ProjectAliB/ProjectAli.github.io/README.md

[Robot Overview by ProjectAli.pdf](https://github.com/ProjectAliB/ProjectAli.github.io/files/14853153/Robot.Overview.by.ProjectAli.pdf)
