ProjectAliB/ProjectAli.github.io/Reports/Weekly reports/# Work session 13 -19032024.md

# Work session 12 - 19/03/2024

## Tasks overview

- Modeling the robot on Fusion 360, along with the robot components.
- Making the wooden base using Laser-cutting machine.

## Modeling

- Using Fusion 360, 4 pieces were modeled according to their dimensions and their position:
  - The wooden base.
  - The Arduino Uno micro-controller.
  - The Jetson nano mini-computer.
  - Bread board.

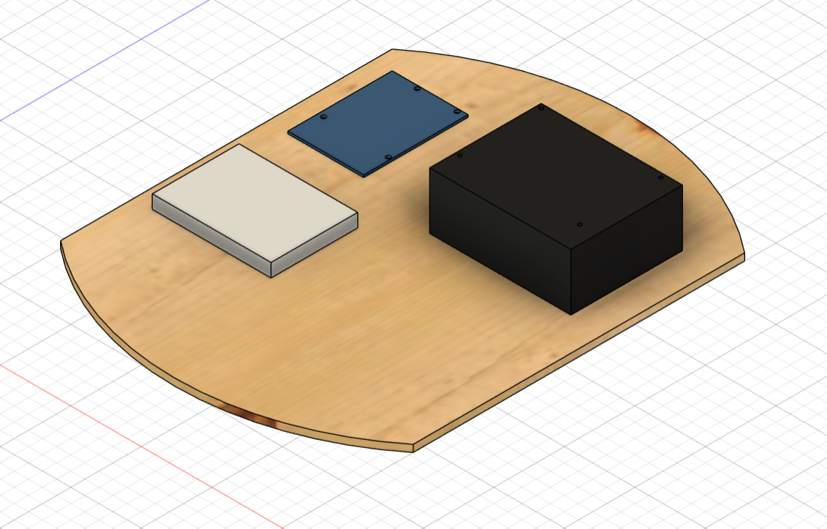
[picture p13: Ressources/Images&Pictures/Work session 13/Screenshot 2024-03-19 152109.png]

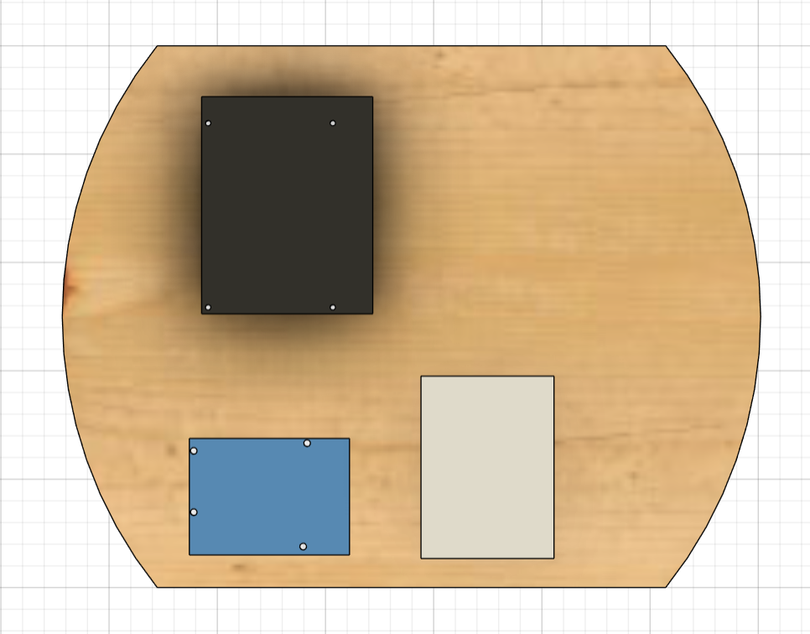
[picture p14: Ressources/Images&Pictures/Work session 13/Screenshot 2024-03-19 152143.png]


## Laser cutting

- Using the sketch from the 3D modeled wooden base as a base, making the wooden base with accurate measures was a success.

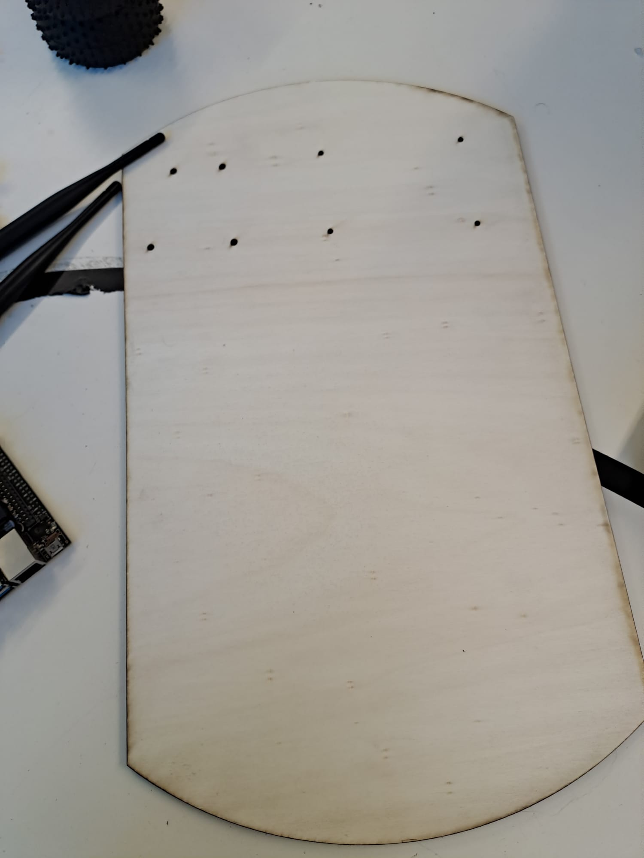
[picture p15: Ressources/Images&Pictures/Work session 13/WhatsApp Image 2024-03-19 at 15.00.32_1b3191f3.jpg]
Base


## Next steps

- Look for solutions for space and wires management.
- Mount other sensors on the robot.
