ProjectAliB/ProjectAli.github.io/Reports/Weekly reports/# Work session 09 - 13022024.md

# Work session 09 - 13/02/2004

## Overview

The focus of this work session was on the possible solutions available for making the front wheels, as well as the power supply for the robot.

## Front wheels

Two choices were available for making the front wheels:
- Have two big wheels, similar in size to the driving wheels, with 3 degrees of freedom using a ball bearing system. This solution put design and outward appearance over practicality as it is very complex to achieve using the available tools.

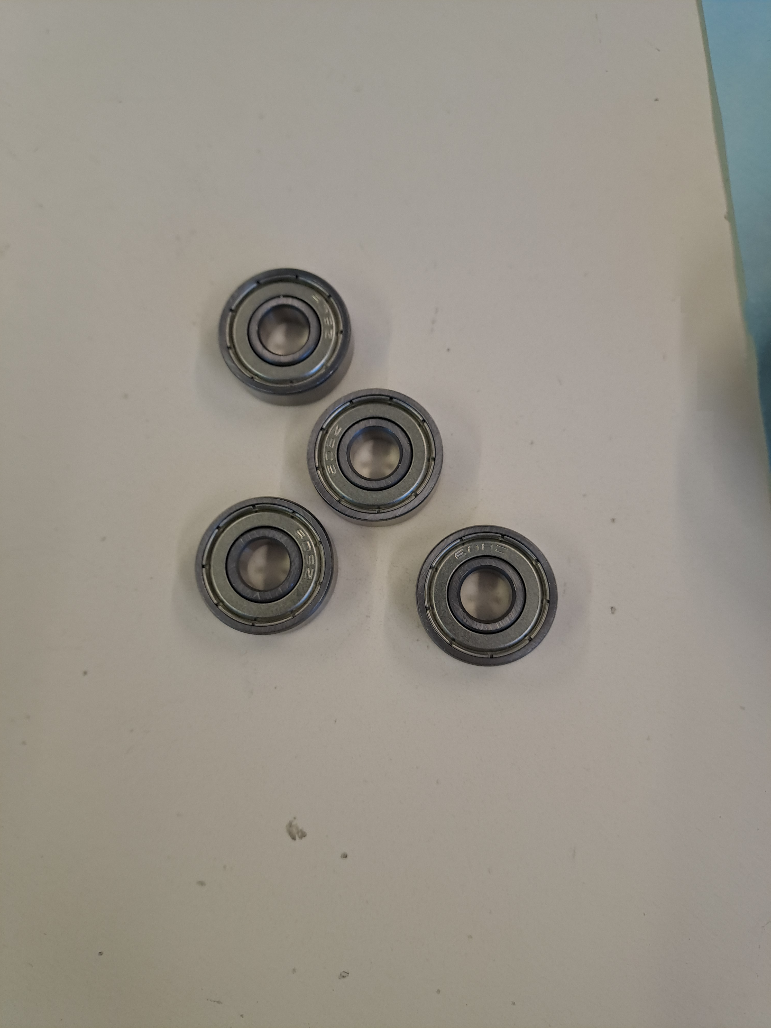
[picture p25: Ressources/Images&Pictures/Work session 10/20240213_103211.jpg]
ball-bearing system


- Using multi-directionnal wheels, a choice that would prioritize practicality over design, and the standard solution for similar robots.

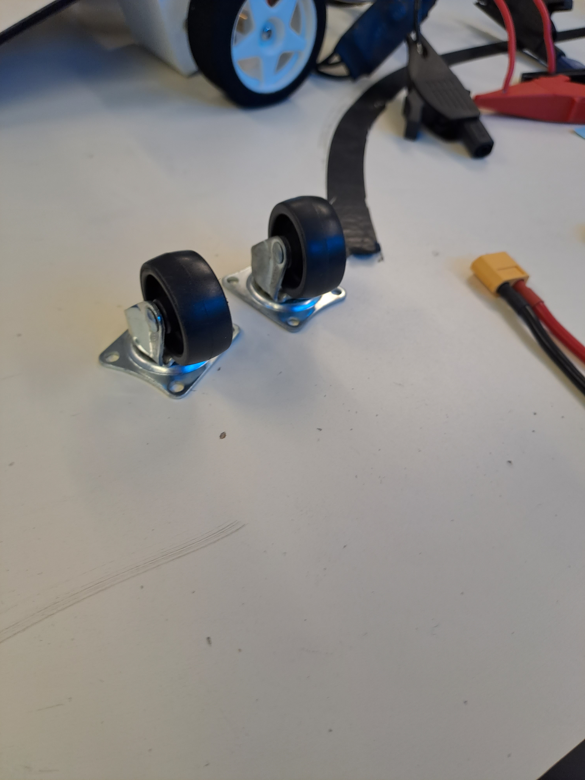
[picture p26: Ressources/Images&Pictures/Work session 10/20240213_103206.jpg]
Multi-directionnal wheels


The choice would be done later after testing both solutions.

## Power supply

In order to accuratly determine the power source (the battery), to use as a power supply for our robot, it is necessary to clarify what components of the robot would need power supply, and what are their specs.
The current situation requires the powering of two brushless motors, each one with the specs below according to their manufacturer:

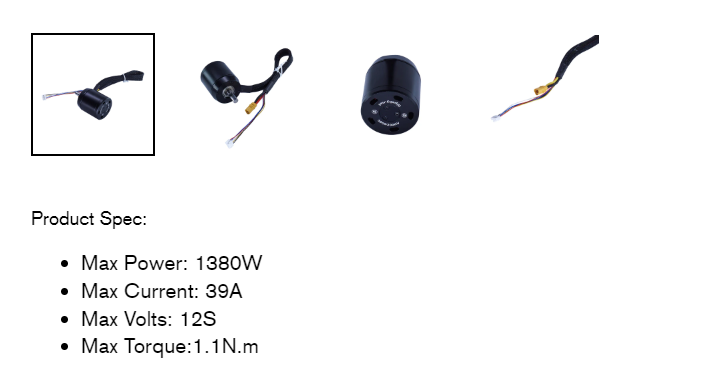
[picture p27: Ressources/Images&Pictures/Work session 10/Screenshot 2024-02-13 090609.png]
Motor specs


The capacity of the battery isn't a priority in the curent situation as this is a prototype.
As a result, the battery used should have the following specs:
- Rated current of 80A.
- Rated voltage of 12V.

Out of the available batteries, the one which is the most adapted is a rechargeable Lithium-Ion battery with thoe following specs:
- Rated current of 66A.
- Rated voltage of 11.1V.
- Capacity of 24.42Wh.

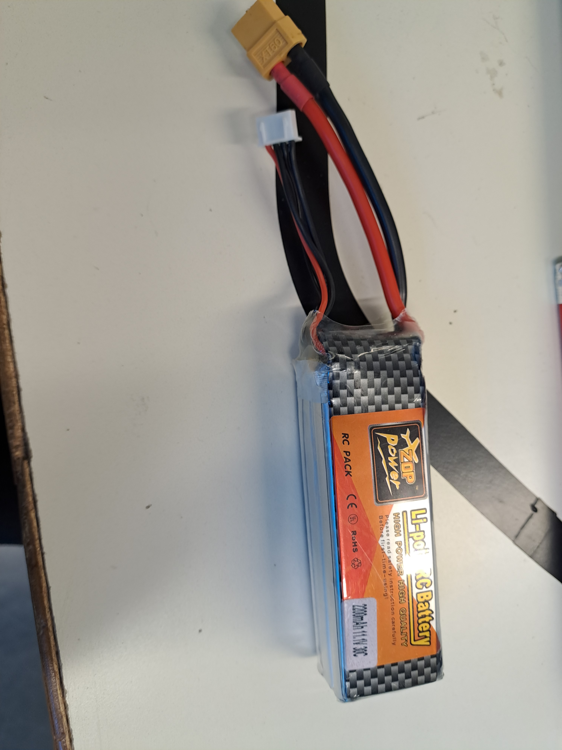
[picture p28: Ressources/Images&Pictures/Work session 10/20240213_091004.jpg]
Li-ion battery


In order to connect the motors to the battery, the following piece was used:

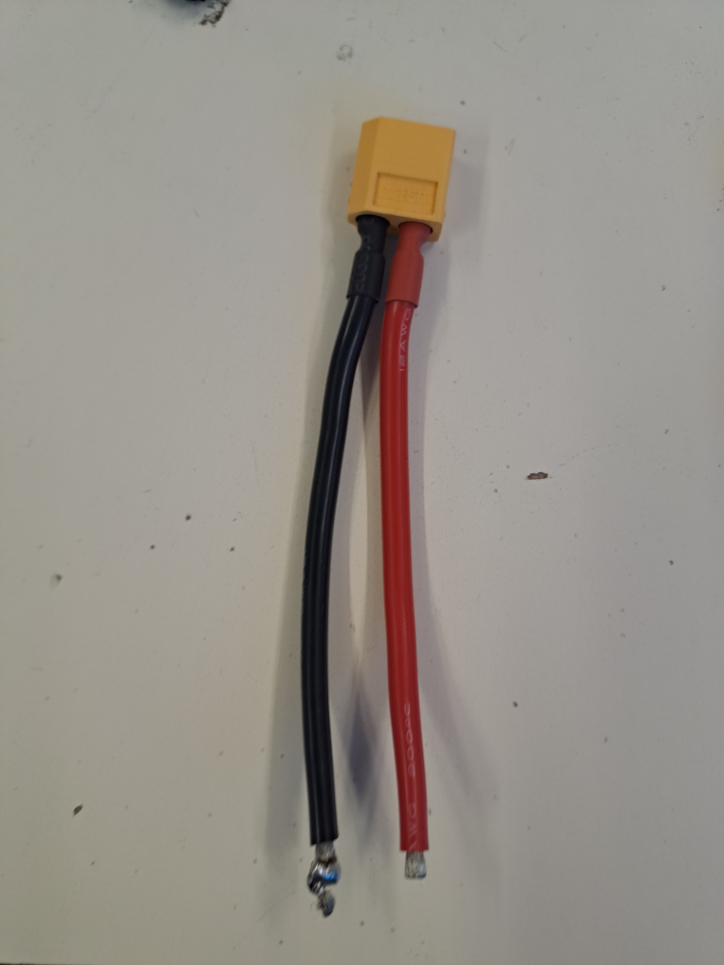
[picture p29: Ressources/Images&Pictures/Work session 10/20240213_103158.jpg]
Y piece


All that was left was welding the to motorrs wires together to connect them both to the battery.

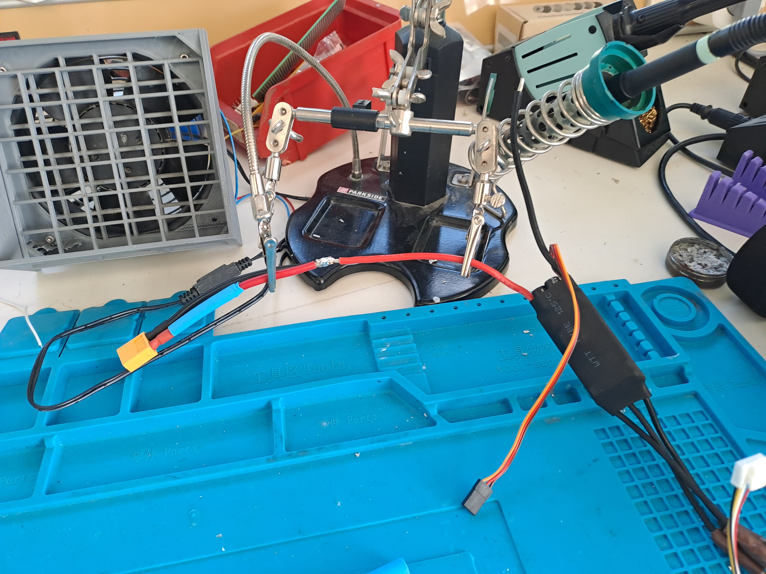
[picture p30: Ressources/Images&Pictures/Work session 10/20240213_105453.jpg]


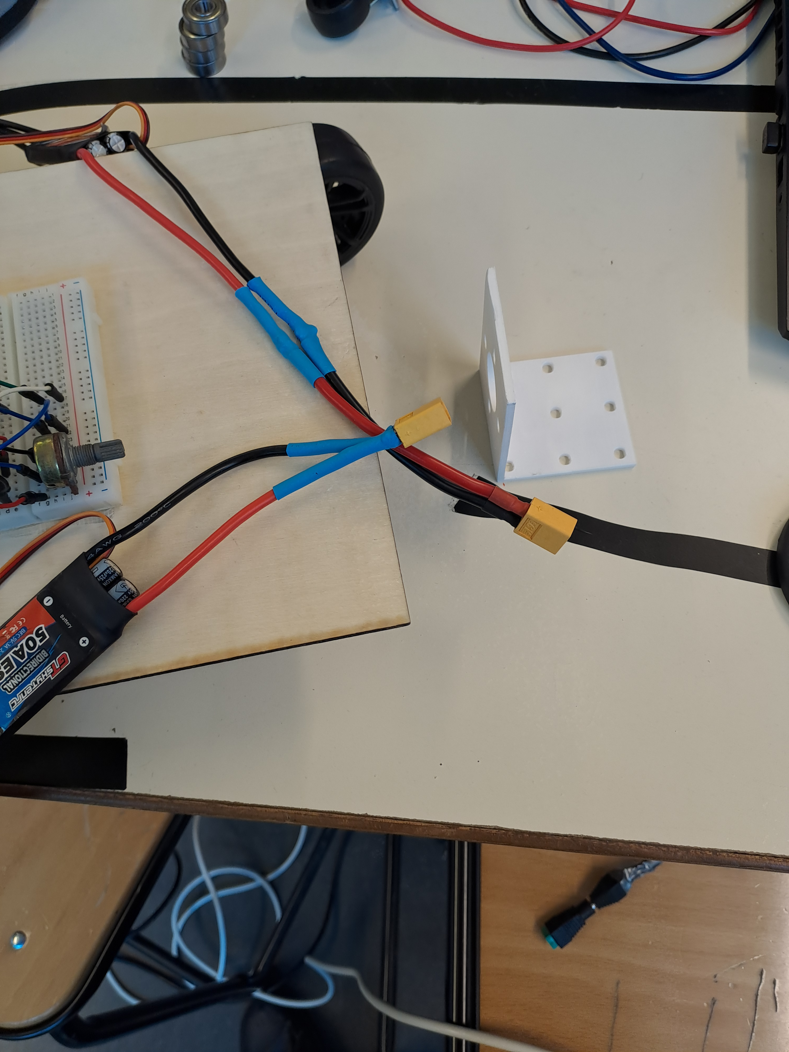
[picture p31: Ressources/Images&Pictures/Work session 10/20240213_113421.jpg]


## Next session goal

Finish welding the wires, connect it to the battery, and install the front wheels.
