ProjectAliB/ProjectAli.github.io/Reports/Weekly reports/# Work session 08 - 07022024.md

# Work session 08 - 07/02/2024

## Overview

During this session, my work consisted of fixing the motors to the frame, as well as fixing the wheels to the already fixed motors.

## Motor fixing

After printing the last version of the support, i fixed the motor to the said support using screw-nut.

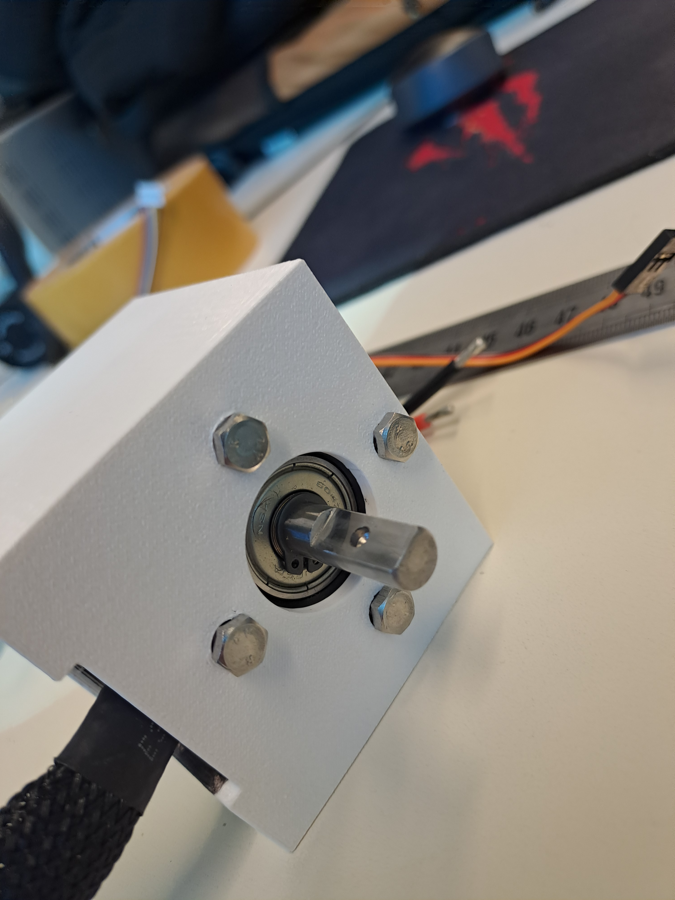
[picture p32: Ressources/Images&Pictures/Work session 08/20240207_151155.jpg]


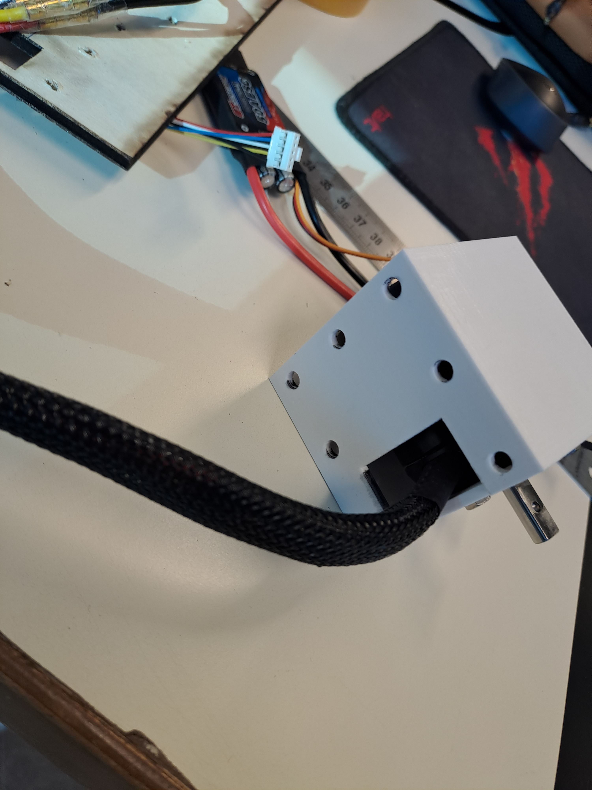
[picture p33: Ressources/Images&Pictures/Work session 08/20240207_151159.jpg]


Following that, I used it to try different positions on the frame. After finding the right position, I used a marker to mark the spot where the support is to be fixed.
I used a drill to bore a whole through the marked spots, making it possible to fix the support on the frame.

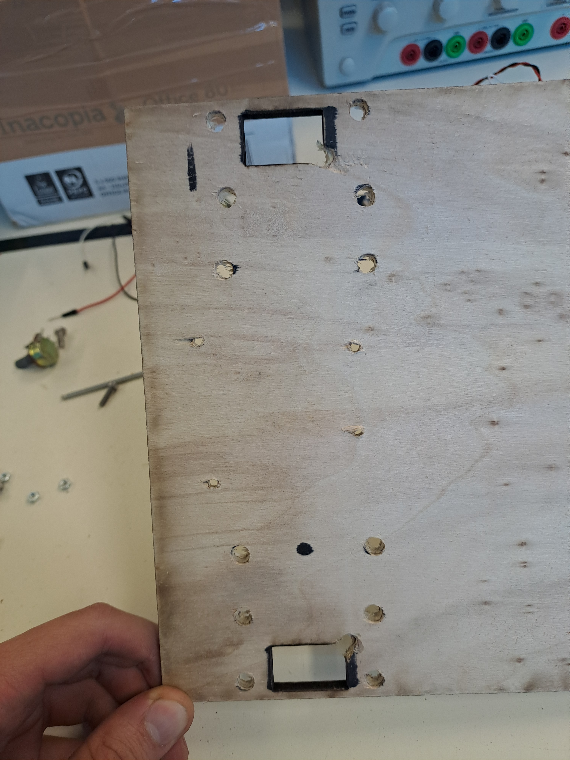
[picture p34: Ressources/Images&Pictures/Work session 08/20240207_153612.jpg]
Frame


## Wheel fixing

Now that the motor was fixed on the frame, it was time for wheels to be fixed to the motors.
I used a coupler connecter to connect the wheel to the motor.
Unfortunately, the connecter had smaller diameter compared to the motor's, which called for  perforation of the said piece to match our need.

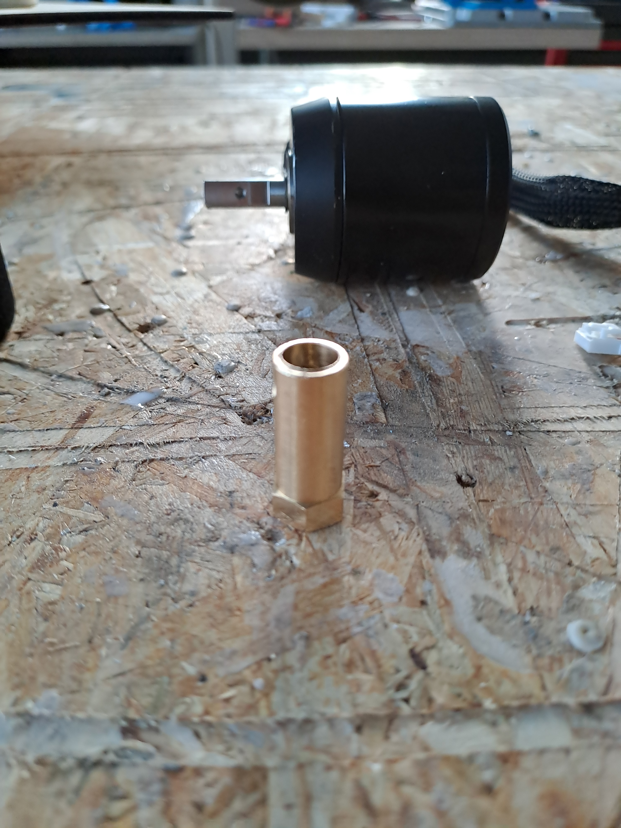
[picture p35: Ressources/Images&Pictures/Work session 08/20240207_172836.jpg]


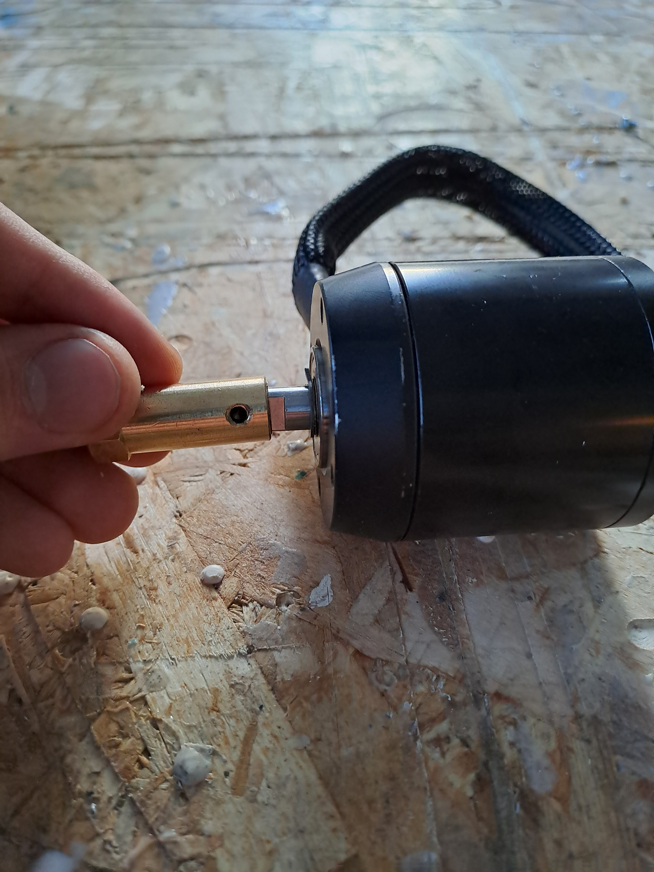
[picture p36: Ressources/Images&Pictures/Work session 08/20240207_172843.jpg]


All that was left was to fix the wheel to the other side of the connecter usig a screw.

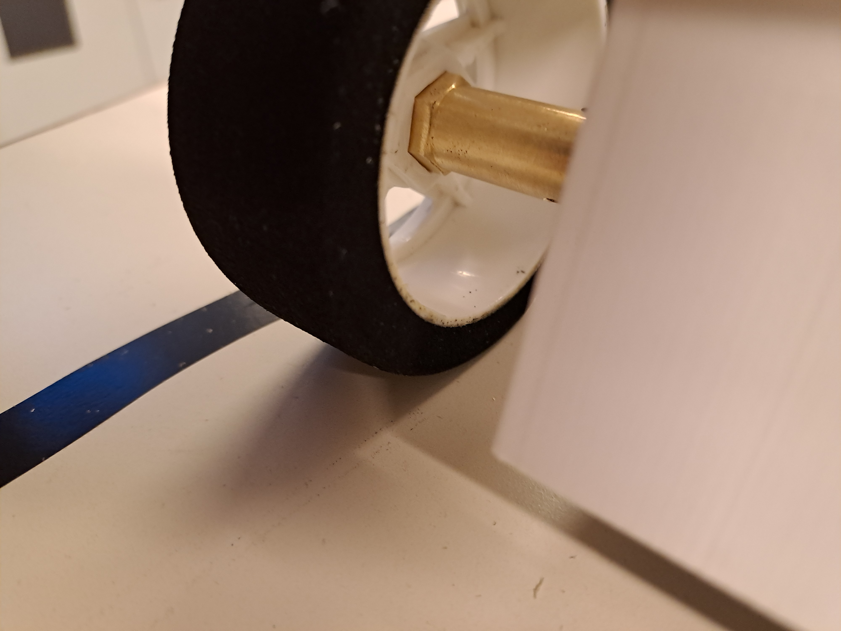
[picture p37: Ressources/Images&Pictures/Work session 08/20240207_174426.jpg]


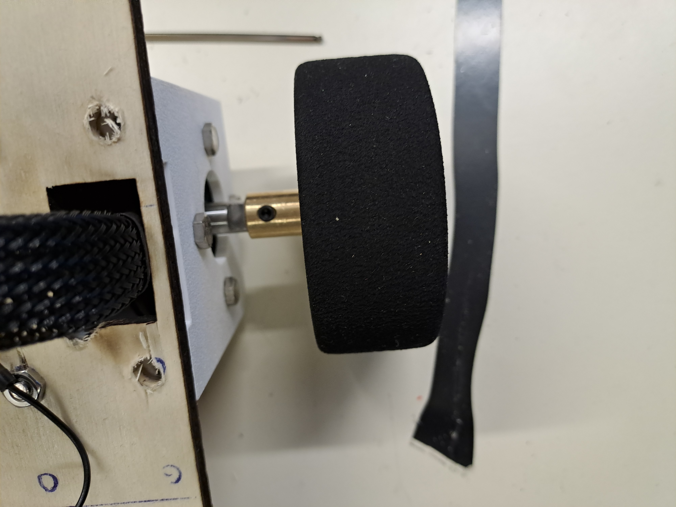
[picture p38: Ressources/Images&Pictures/Work session 08/20240207_174417.jpg]


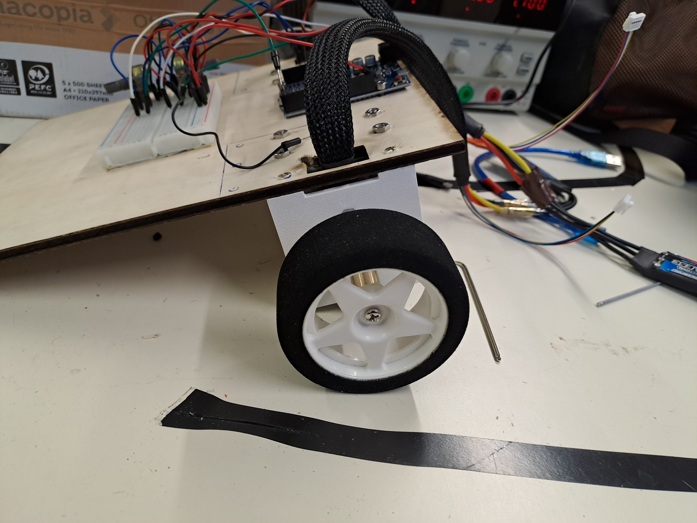
[picture p39: Ressources/Images&Pictures/Work session 08/20240207_174414.jpg]


## Next session goal

Make the robot's front wheel.
