ProjectAliB/ProjectAli.github.io/Reports/Weekly reports/# Work session 07 - 23012024.md

# Work session 07 - 23/01/2024

## Overview

My task this time consisted of reviewing the motor suport and fixing the electronic hardware in the robot frame.

## Motor support

After fixing the motor to the first version of the support using a screw-nut system, it appeared the support material wasn't rigid enough to support the weight of the motor.

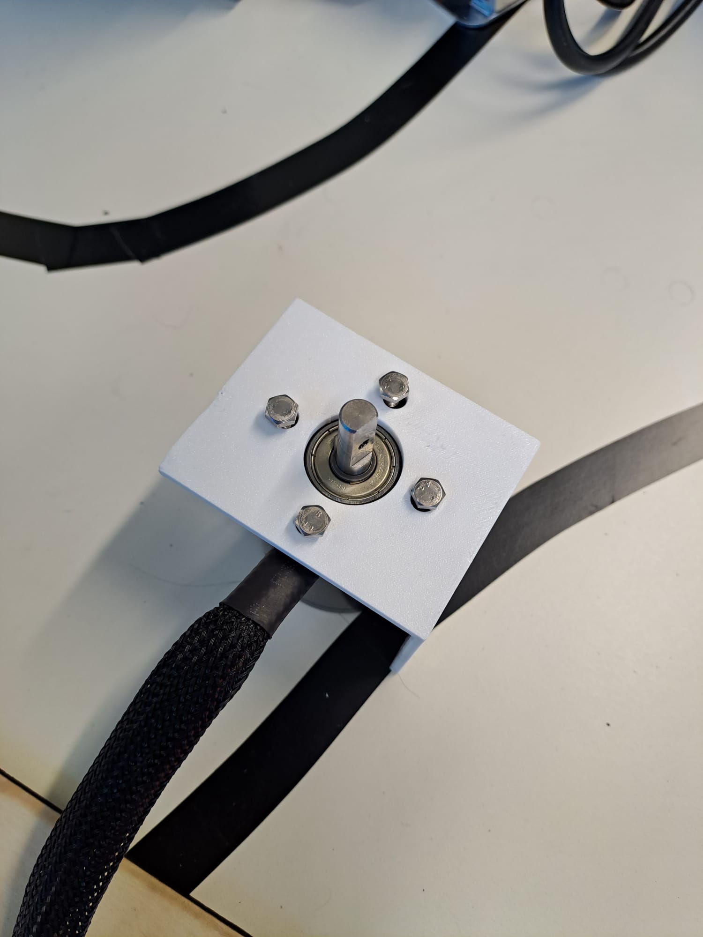
[picture p40: Ressources/Images&Pictures/Work session 07/IMG-20240123-WA0006.jpg]
Support Vers 1.0


As a result, i modeled a second one with butress from each side of the support to further support the motor and ensure the durability of the material.
Moreover, as the wires of the motor were getting in the way of the support, i took that into consideration and made a rectangular slot at the base of the support to avoid any perturbations dring the robot's movement.

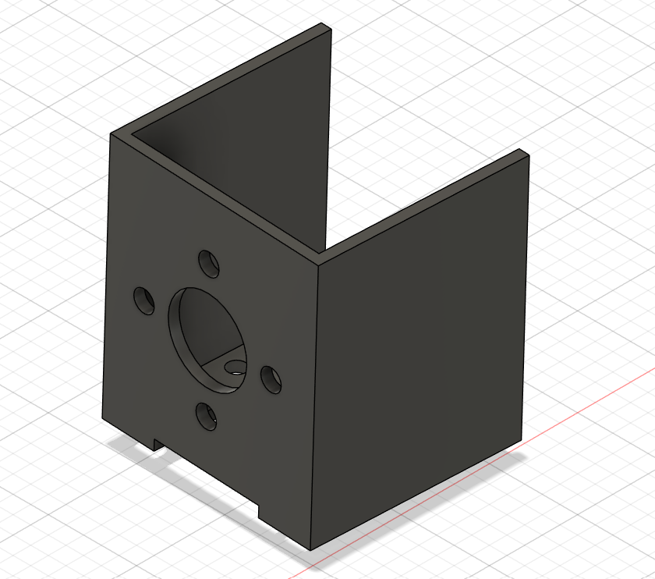
[picture p41: Ressources/Images&Pictures/Work session 07/Screenshot 2024-01-23 093651.png]


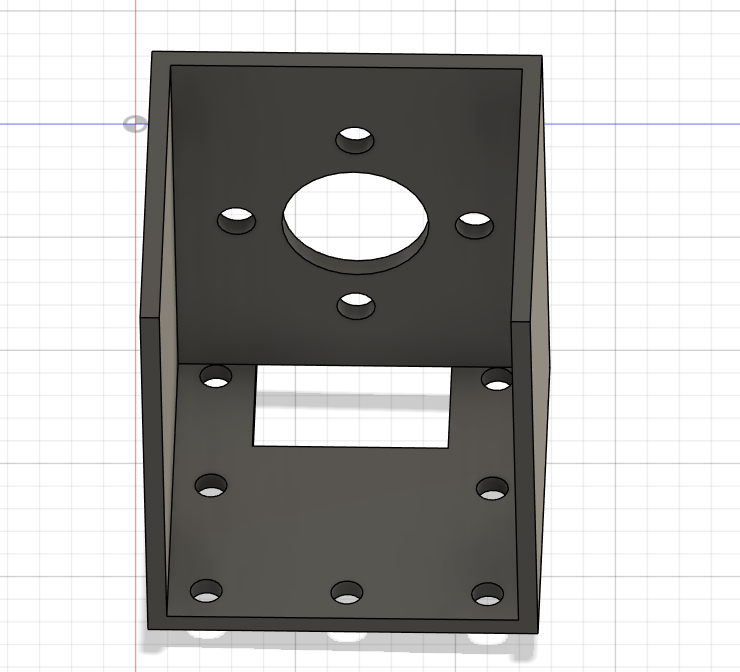
[picture p42: Ressources/Images&Pictures/Work session 07/Screenshot 2024-01-23 093956.png]


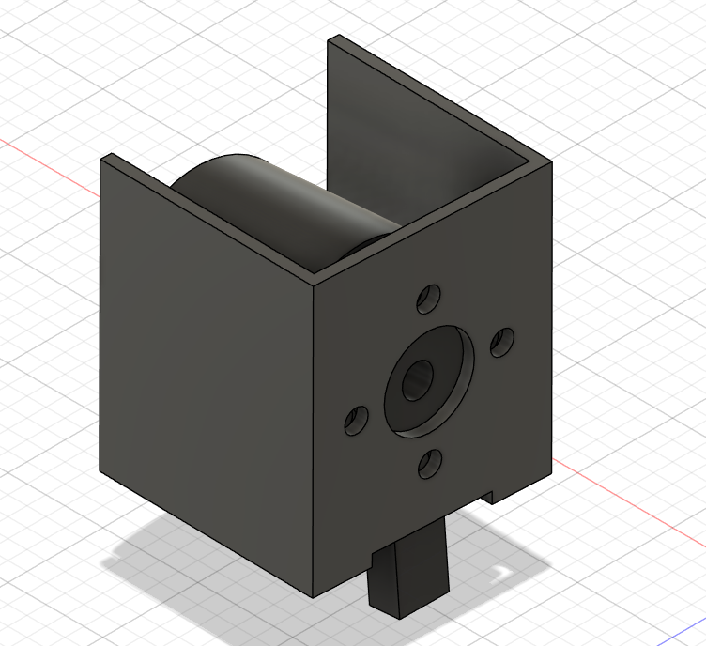
[picture p43: Ressources/Images&Pictures/Work session 07/Screenshot 2024-01-23 094402.png]


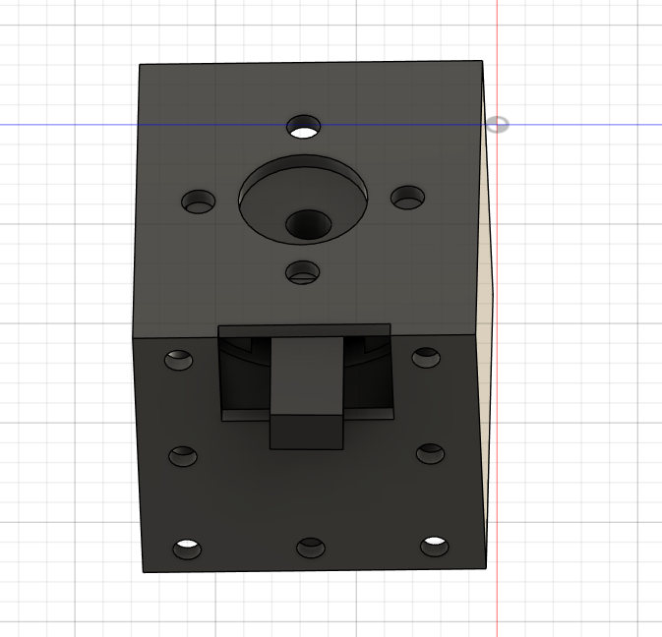
[picture p44: Ressources/Images&Pictures/Work session 07/Screenshot 2024-01-23 094431.png]


## Frame Fixing

Using the wood plan from last time as a frame for the robot, i fixed both the micro-controller (Arduino Uno) and the breadboard, using a screw-nut system for the first and a double sided tape for the second.

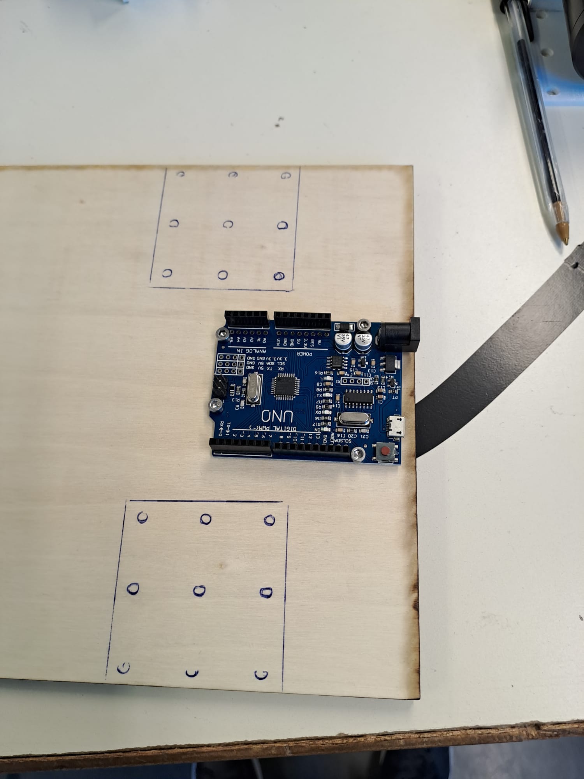
[picture p45: Ressources/Images&Pictures/Work session 07/IMG-20240123-WA0002.jpg]


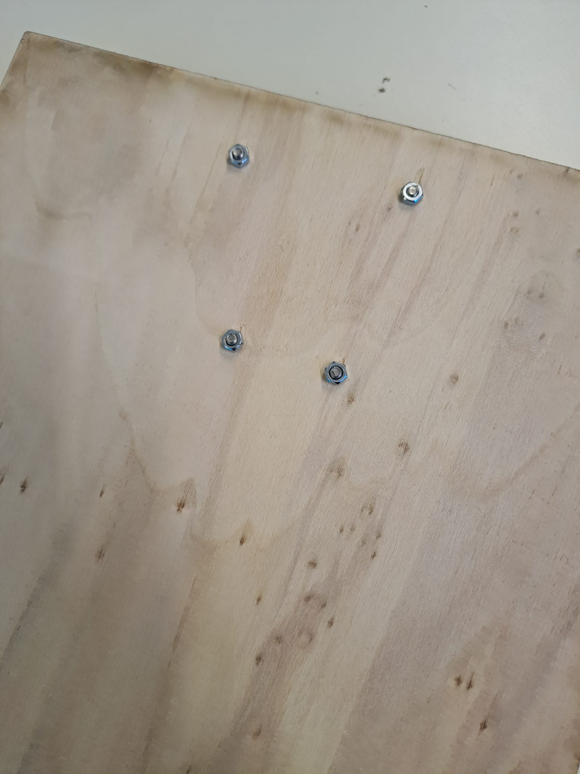
[picture p46: Ressources/Images&Pictures/Work session 07/IMG-20240123-WA0003.jpg]


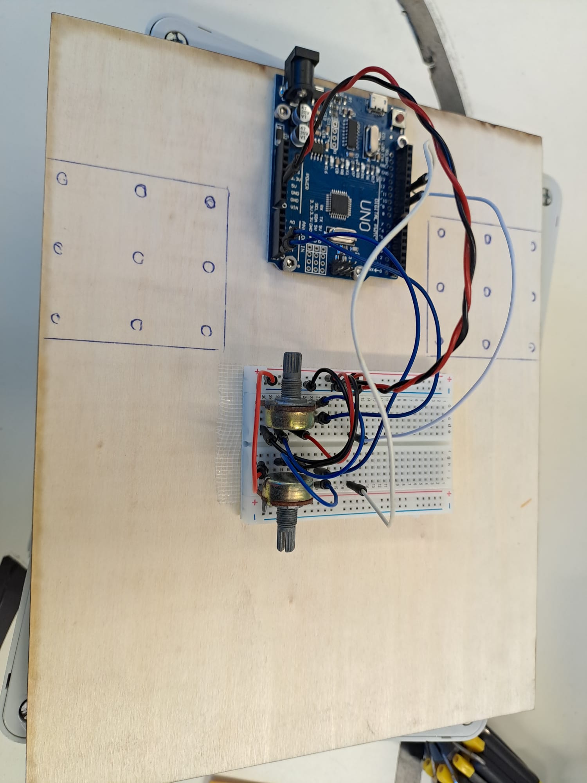
[picture p47: Ressources/Images&Pictures/Work session 07/IMG-20240123-WA0004.jpg]
Breadboard

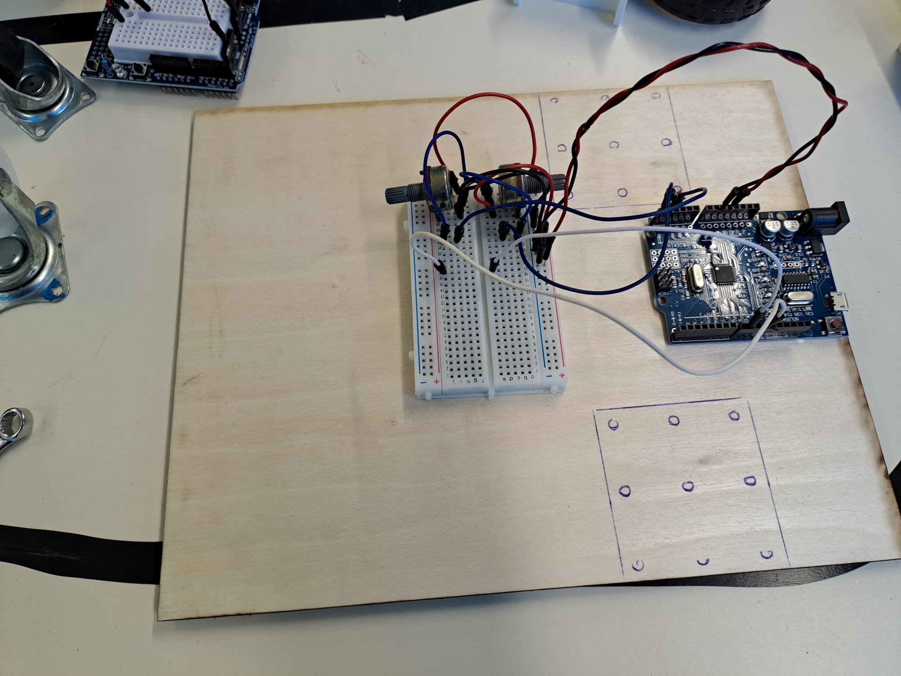
[picture p48: Ressources/Images&Pictures/Work session 07/IMG-20240123-WA0007.jpg]
Frame


## Next session goal

Reviewing the new version of the support and fix it along with the motors on the robot frame. Start working on the robot wheels.
