ProjectAliB/ProjectAli.github.io/Reports/Weekly reports/# Work session 06 - 16012024.md

# Work session 06 - 16/01/2024

## Overview

During this work session, i focused on setting the robot frame.

## Robot frame

I printed the motor support that i modeled before using a 3D printer. The results were satisfying as all the measures were right. I then moved on to place the support on what would the base of the robot. It is a rectangular wood plank 5mm in thickness and about 300mm in width and 500mm in lenth obtained using laser cutting.

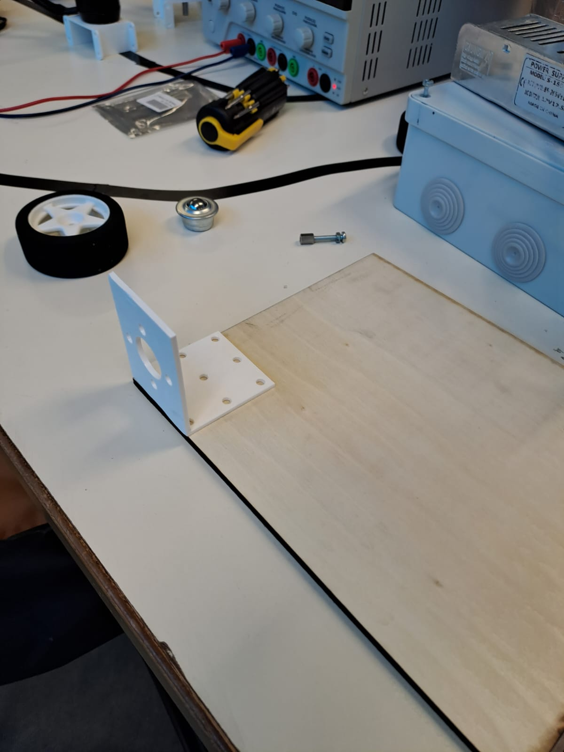
[picture p49: Ressources/Images&Pictures/Work session 06/WhatsApp Image 2024-01-17 at 10.24.28_634c170a.jpg]
Support+Plank


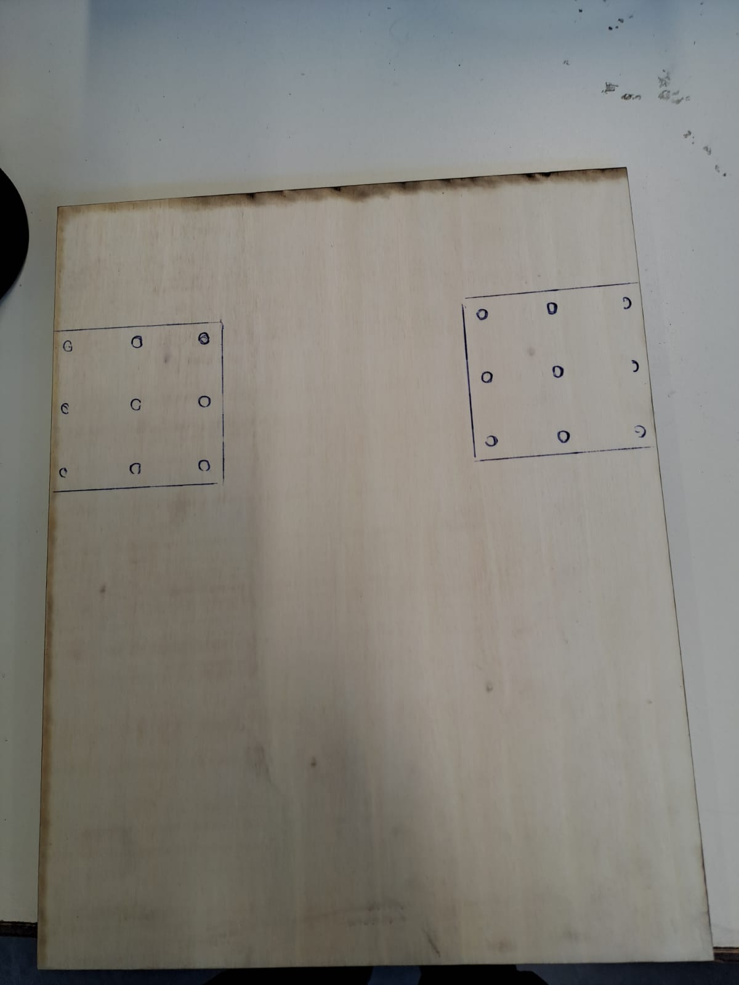
[picture p50: Ressources/Images&Pictures/Work session 06/WhatsApp Image 2024-01-17 at 10.24.28_70d6efe8.jpg]
Support Position


However, due to the motor's considerable weight, it may be better to add a butress at each side of the support to ensure that it will not break due to the motor's weight.

## Next session's goal

Make an enhanced version of the support using butress. Test the new printed piece and fix it on the wood plank.
