ProjectAliB/ProjectAli.github.io/Reports/Weekly reports/# Work session 01 - 13112023.md

# Work session 01 - 13/11/2023

## Overview

My work this session was mainly focused on finding the right motor that fulfills our need for the vehicle.

## Documentation

Our aim is to build a vehicle that respects the following criteria:
- Light-wheighted
- Speed reaching 45km/h
- Cheap and affordable
- Simple to assemble
- Long cycle of life
- Energy efficient

Having an motor adapted to those needs is therefore neccessary. Out of the many suppliers and manufactures of motors, we limited our options to the following ones:
- [Ozo ](https://ozo-electric.com/fr/moteurs-roues-arrieres-250w-a-2000w/991015-moteur-dd35-transport-arriere-direct-drive-2000w.html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)
- [AliExpress ](https://fr.aliexpress.com/item/1005004625728818.html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)
- [CDiscount ](https://www.cdiscount.com/le-sport/velos-tandem-tricycle-monocycle-remorque-casque/ashata-moteur-de-moyeu-de-roue-de-14-po-36v-72v-20/f-121192408-ash1690390599089.ht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)

AS the three motors share nearly the same specifics, after a careful consideration of the product's price, delivering fees, and the possibility to contact the manufacturer when needed, we chose the Ozo product:
Ozo hub motor
Motor's dimensions(mm)
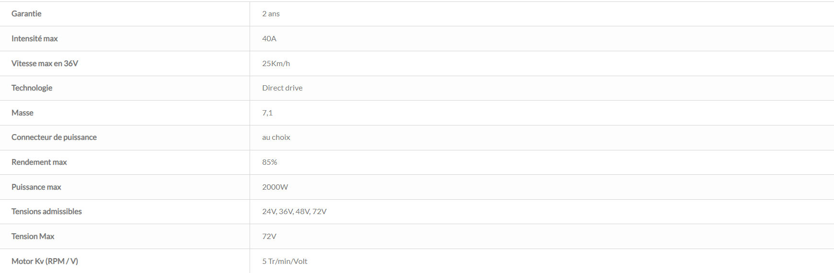
[picture p69: Ressources/Images&Pictures/Screenshot 2023.png.png]
Technical sheet


  ## Motor test

As it is my first time using a brushless motor, i tried using one and making it run at a certain speed. The used code was as follows :

    const int moteur=5;
    void setup(){
    pinMode(moteur,OUTPUT);
    Serial.begin(9600);
    }
    void loop(){
    digitalWrite(moteur,0);
    digitalRead(moteur);
    delay(5000);
    digitalWrite(moteur,1);
    digitalRead(moteur);
    }
Carefully connecting each wire into its suitable pin, there was no apparent mistake in the installation.

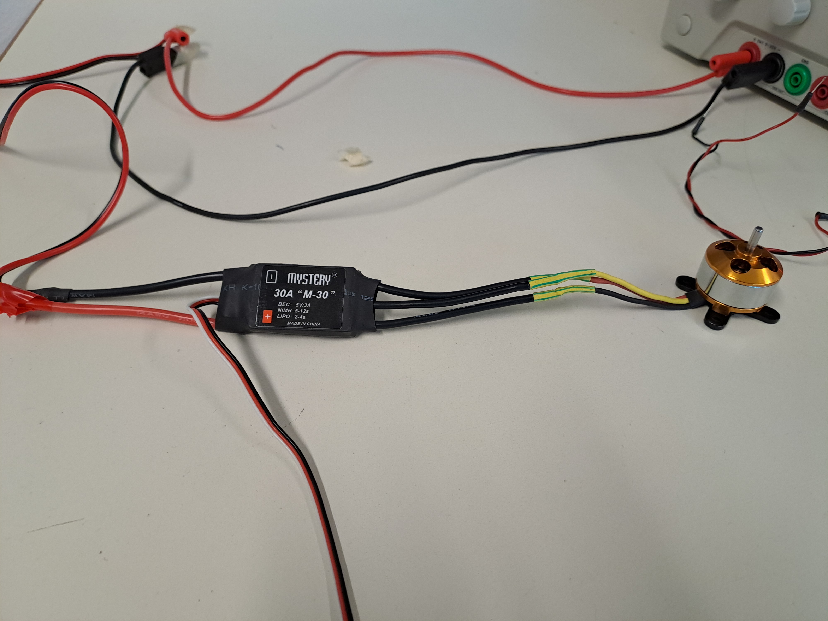
[picture p70: Ressources/Images&Pictures/20231116_153714.jpg]

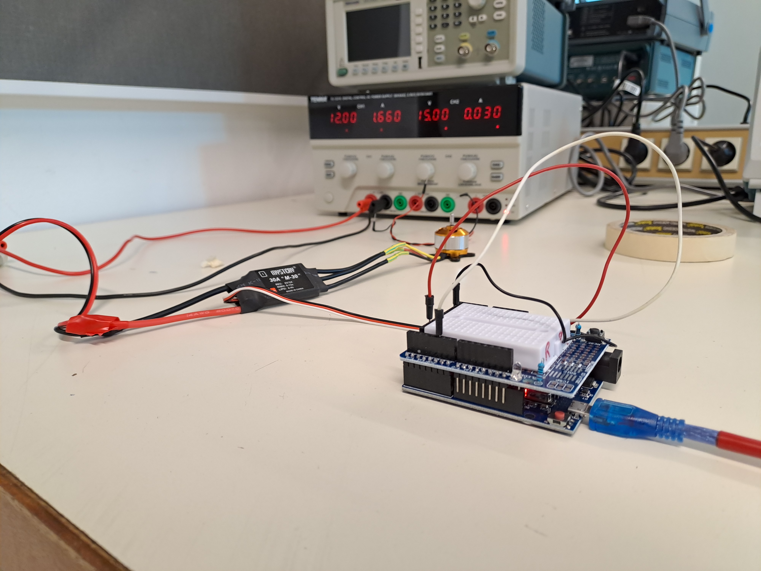
[picture p71: Ressources/Images&Pictures/20231116_153720.jpg]


The motor however still didn't seem to be working, although it was alimented by 12V. The problem may reside ine the code.

## Next goal

Looking for a code that enables me to control the speed of the brushless motor.
