ProjectAliB/ProjectAli.github.io/Soutenance Projet/Support_soutenance.pdf

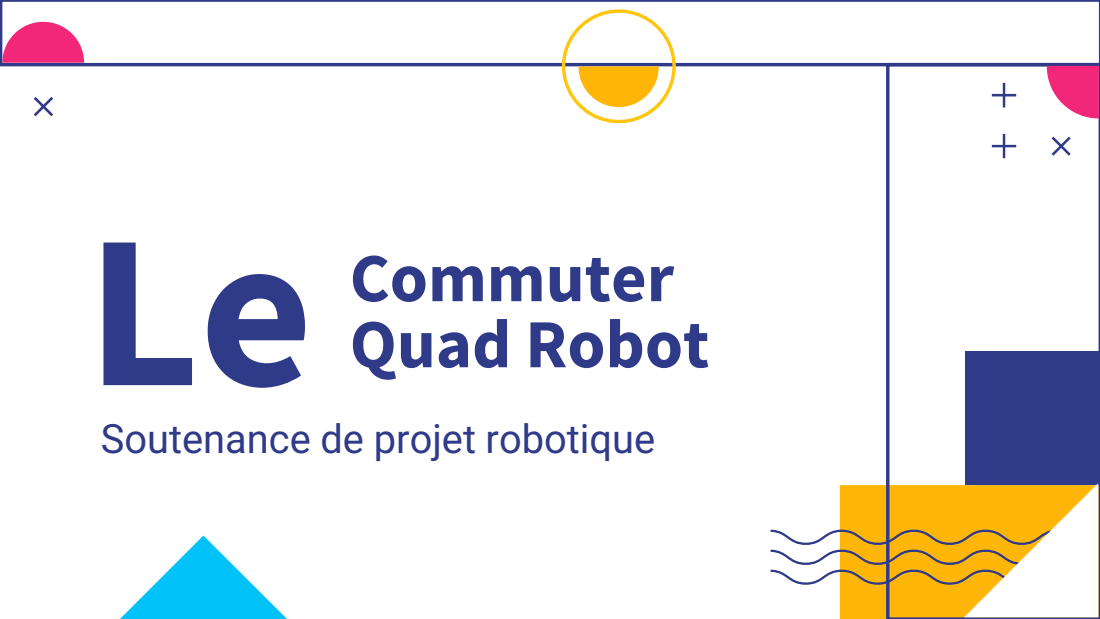
[picture p83: page 1]
Commuter Quad Robot

Soutenance de projet robotique

# Table des matières

01 Introduction | Explication du cadre du projet
02 Synopsis | Synopsis de l’architecture
03 Machine à état | Clarification du processus
04 Choix faits | Justification des options prises
05 Futures tâches | Les évolutions à venir

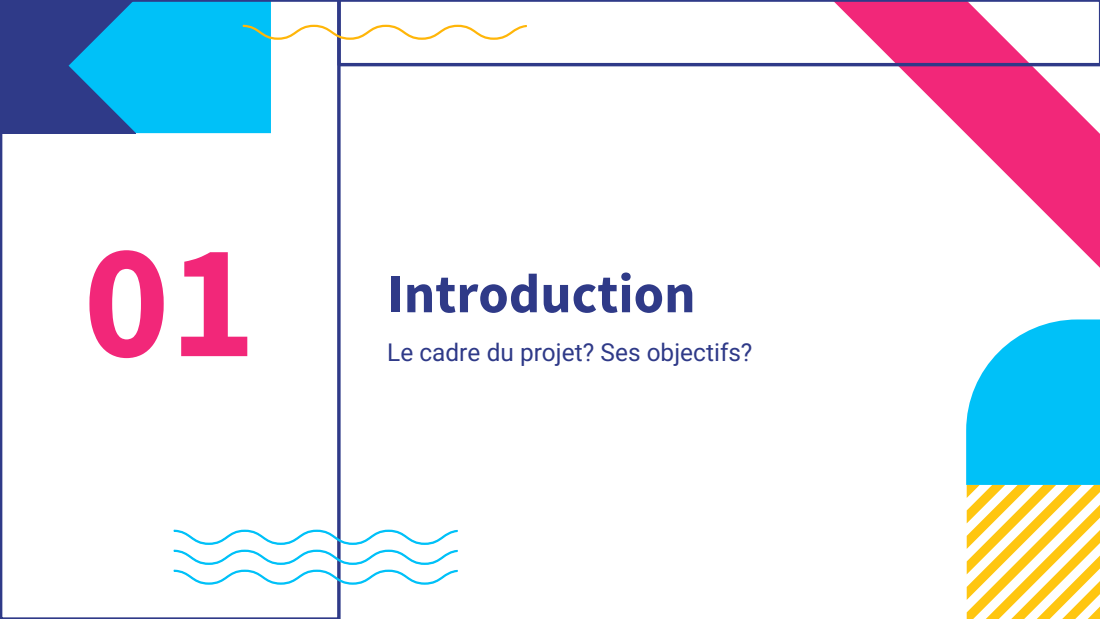
[picture p84: page 3]
Introduction 01; Le cadre du projet? Ses objectifs?

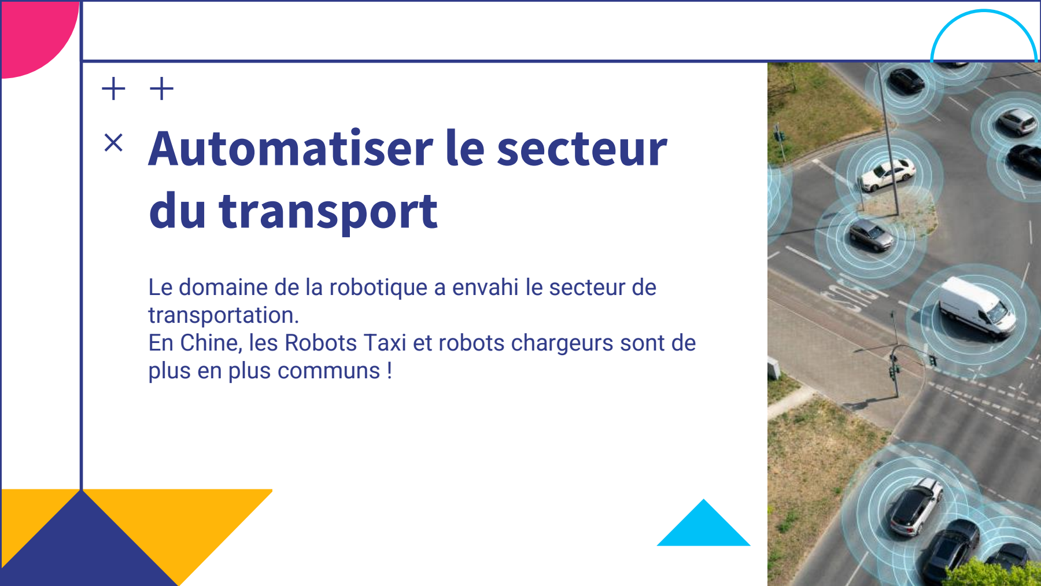
[picture p85: figure]
Automatiser le secteur du transport; transportation.; plus en plus communs !

Le domaine de la robotique a envahi le secteur de

En Chine, les Robots Taxi et robots chargeurs sont de

# Objectifs

Non-soumis au
nombre limité
d’heure de travail

24h24 7J/7

Peu-consommant et
auto-suffisant en
énergie

## Auto-suffisant

Capable d’une
variété de
manoeuvres en
fonction de la
situation

## Intelligent

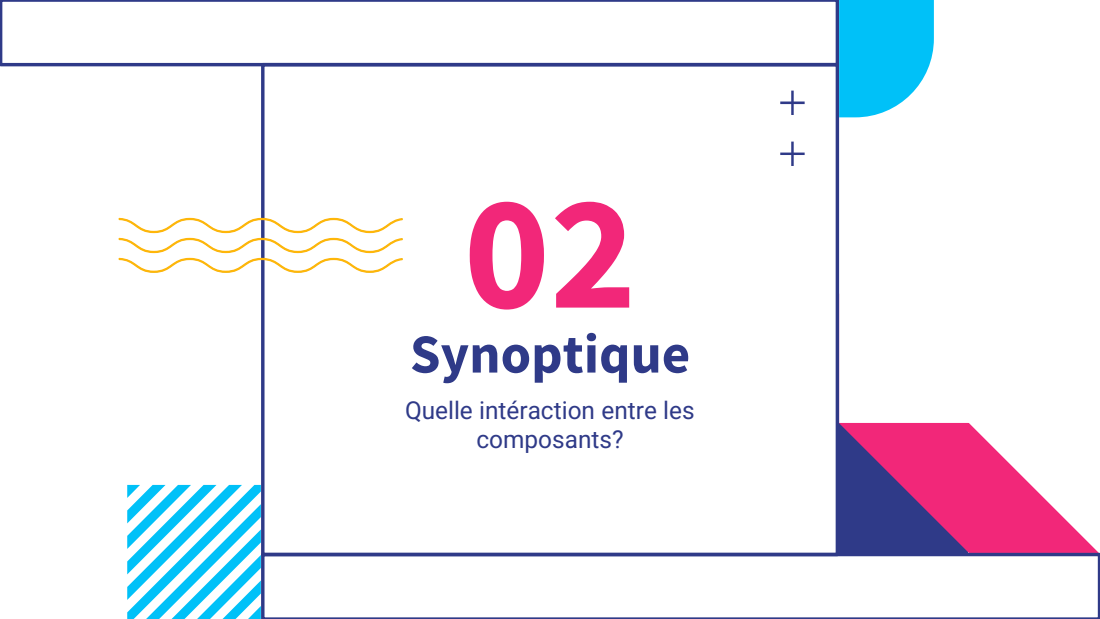
[picture p86: page 6]
Synoptique

Quelle intéraction entre les
composants?

# Composants du robot

## Ordinateur de bord

Caméra | Microcontrôleur
Moteurs | Driver | Servomoteur

# Synopsis simple

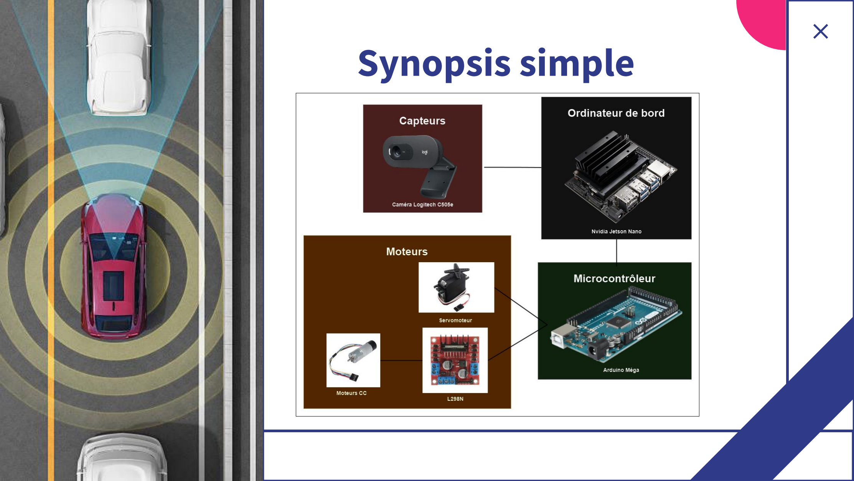
[picture p87: page 8]
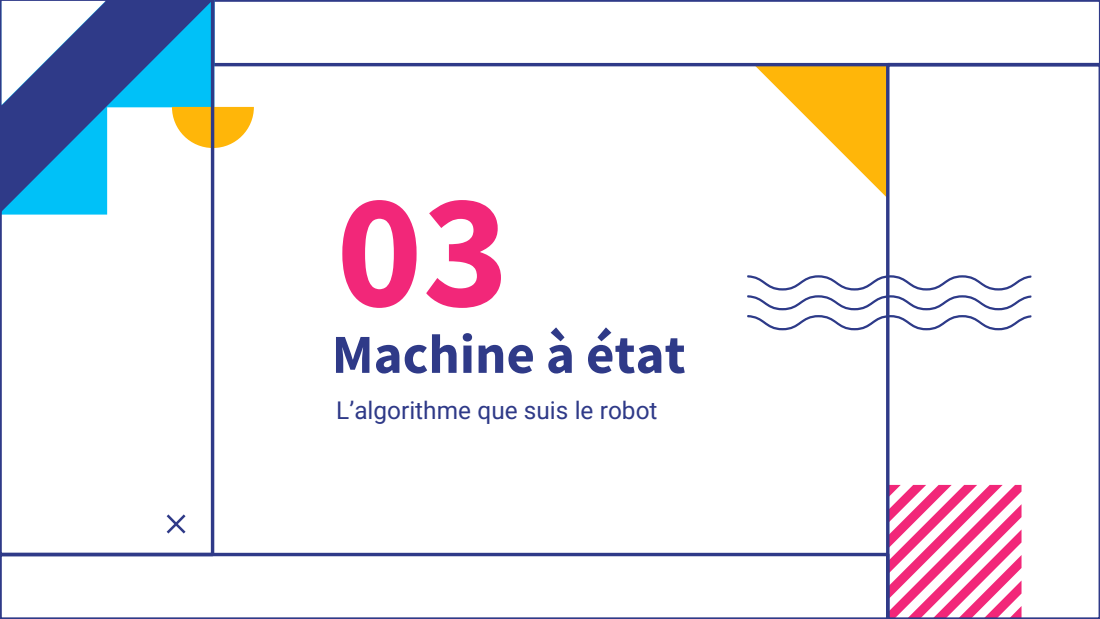
[picture p88: page 9]
Machine à état

L’algorithme que suis le robot

# Les 3 états du robot

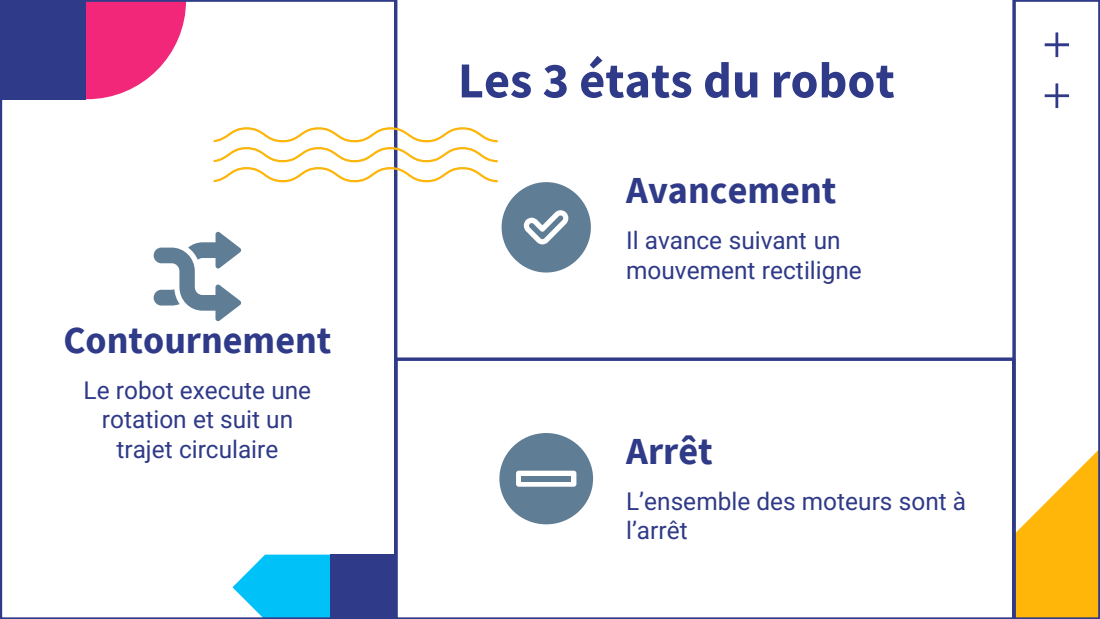
[picture p89: page 10]
Contournement; Avancement; Arrêt

Il avance suivant un
mouvement rectiligne

Le robot execute une
rotation et suit un
trajet circulaire

L’ensemble des moteurs sont à
l’arrêt

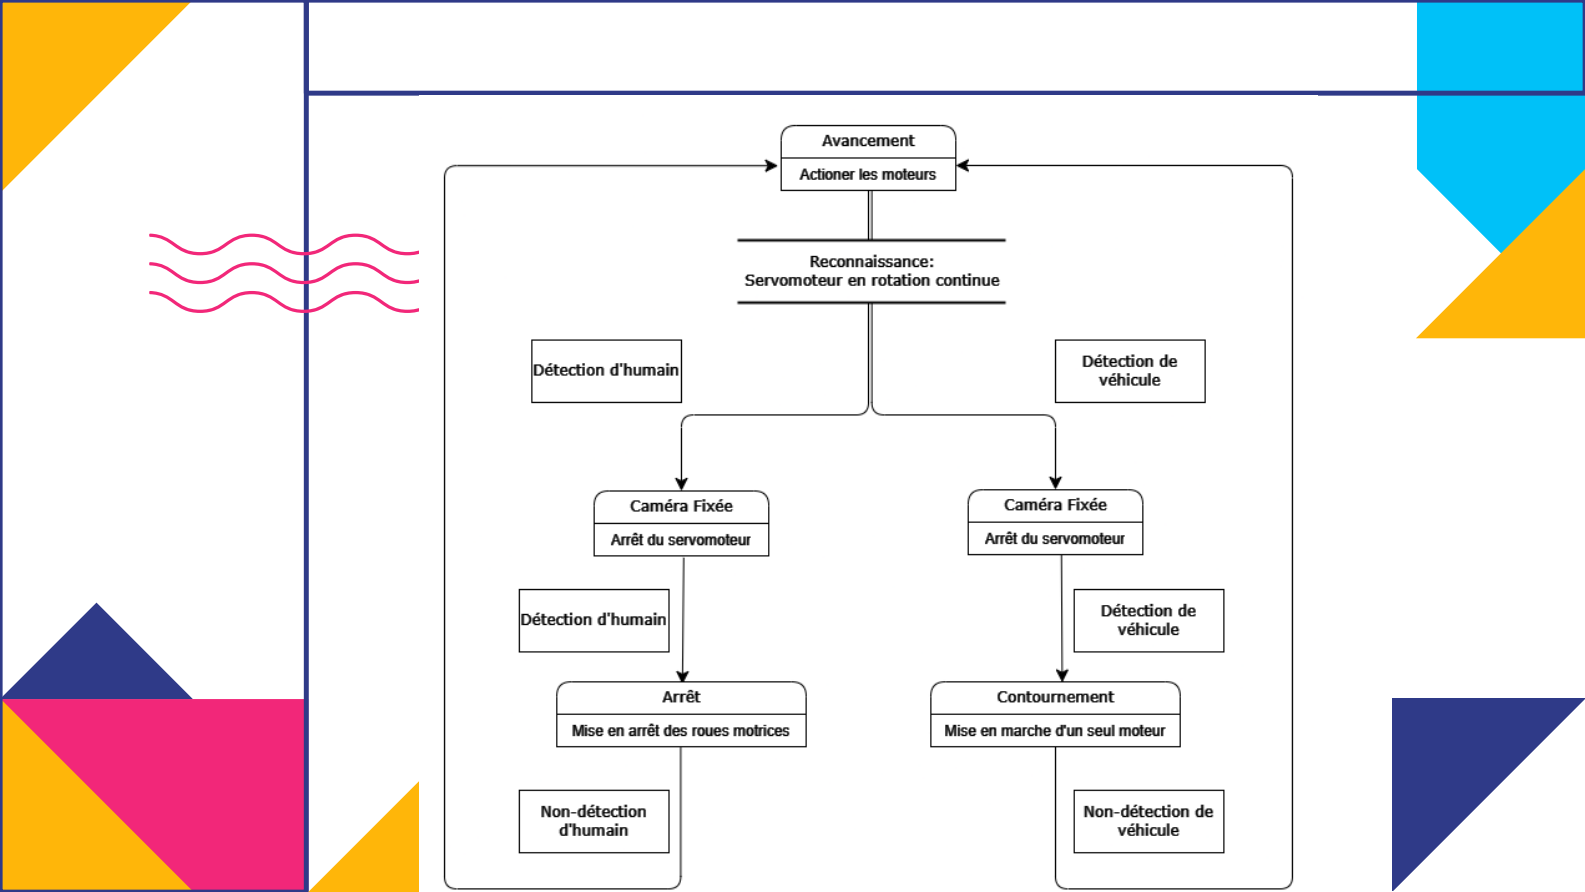
[picture p90: page 11]

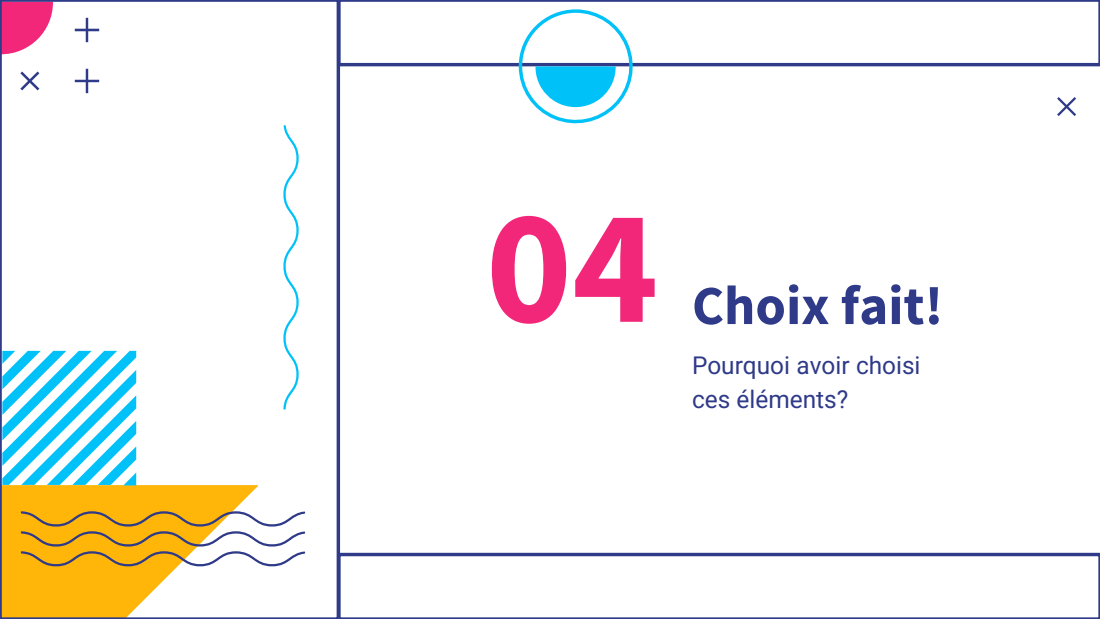
[picture p91: page 12]
04 Choix fait!

Pourquoi avoir choisi
ces éléments?

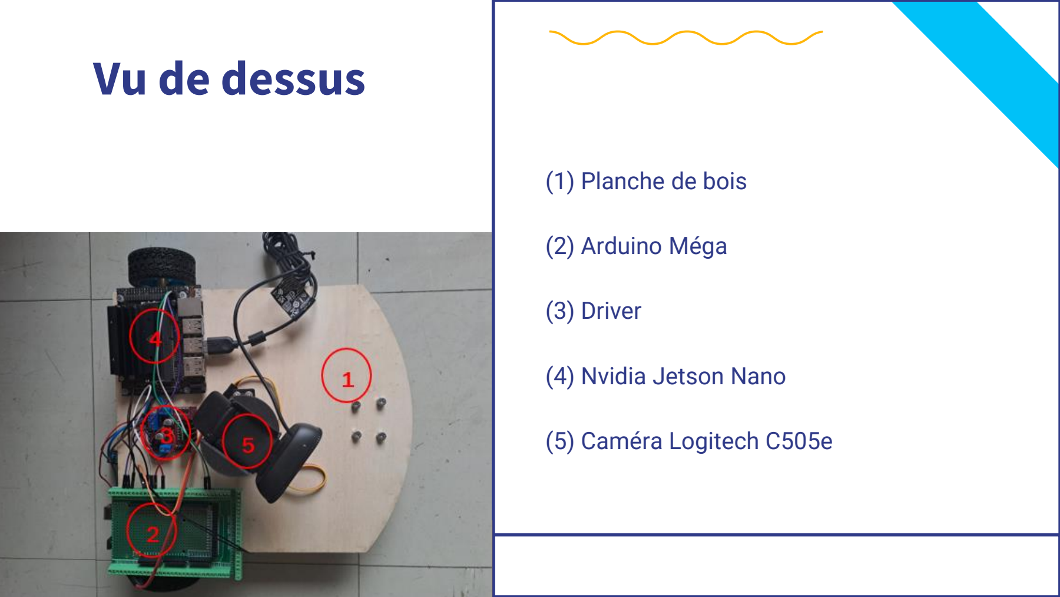
[picture p92: figure]
Vu de dessus; (1) Planche de bois; (2) Arduino Méga; (3) Driver; (4) Nvidia Jetson Nano; (5) Caméra Logitech C505e

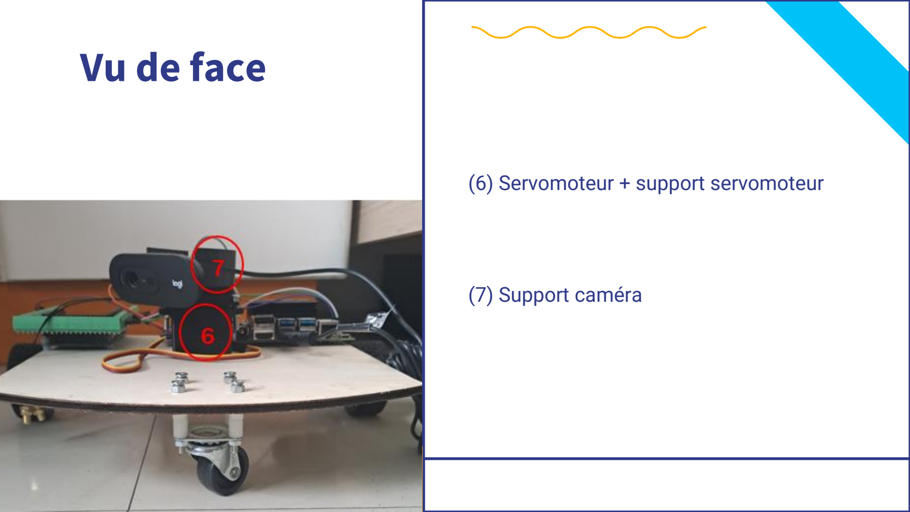
[picture p93: figure]
Vu de face; (6) Servomoteur + support servomoteur; (7) Support caméra

# Les modèles 3D des supports

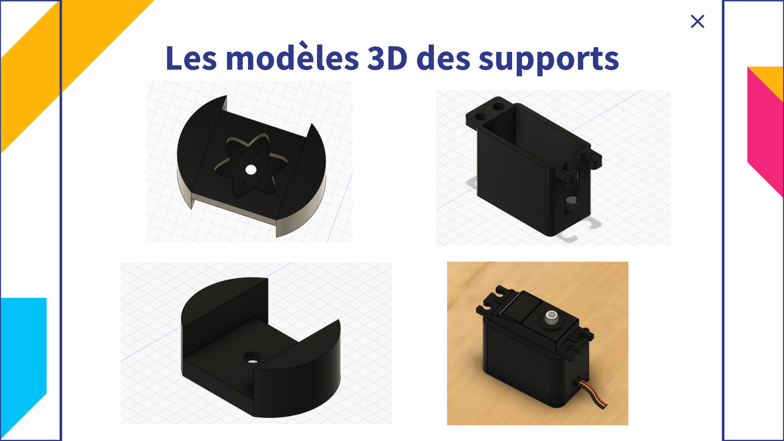
[picture p94: page 15]

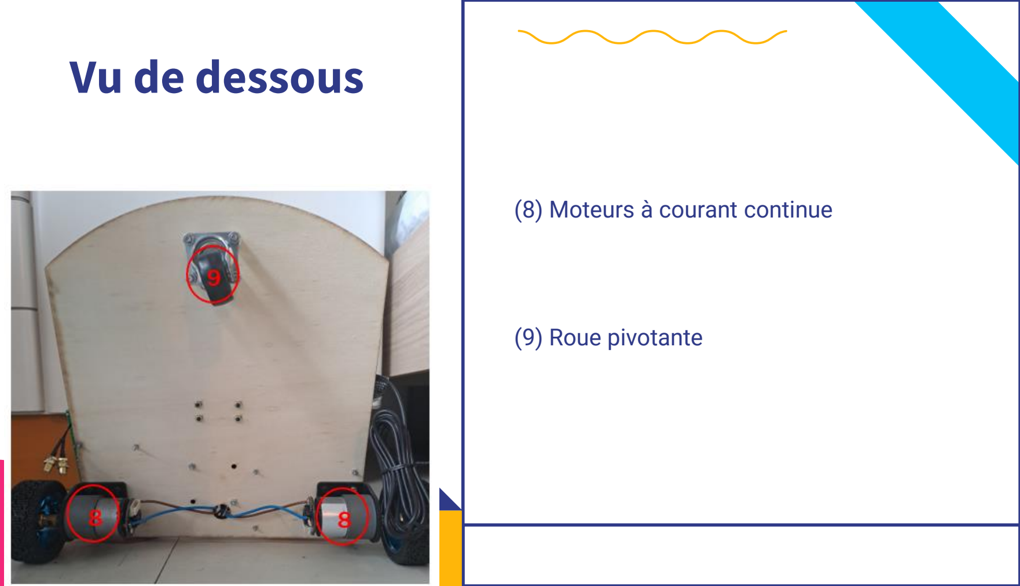
[picture p95: figure]
Vu de dessous; (8) Moteurs à courant continue; (9) Roue pivotante

Futures tâches 05 Qu’est-ce qui reste à faire?

# Next

Système d’alimentation | Classes détectables

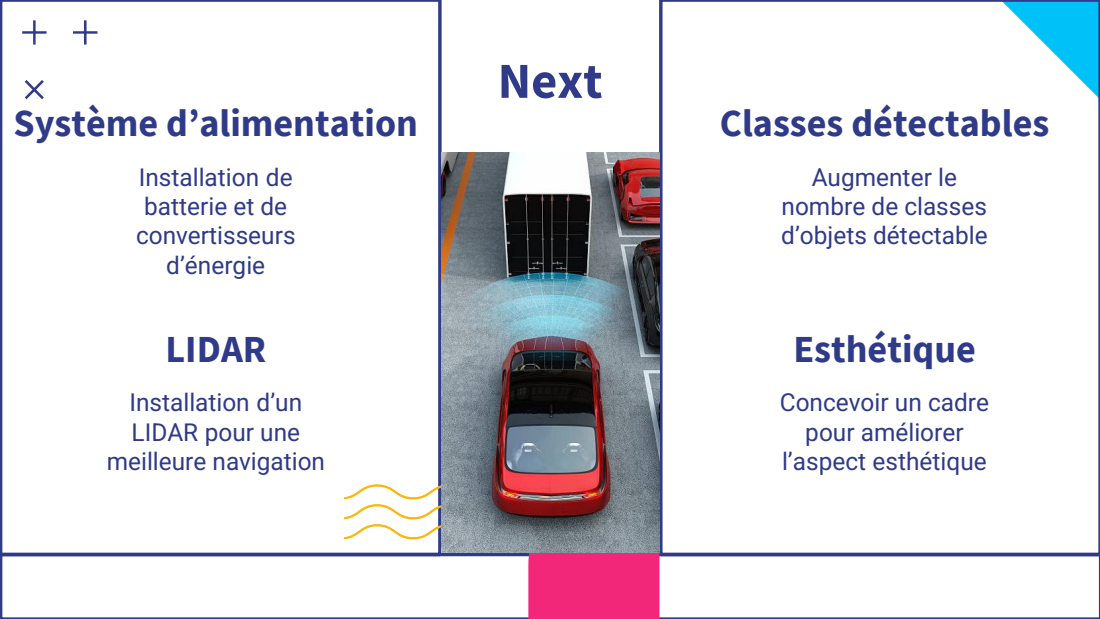
[picture p96: page 18]
LIDAR; Esthétique

Installation de
batterie et de
convertisseurs
d’énergie

Augmenter le
nombre de classes
d’objets détectable

Installation d’un
LIDAR pour une
meilleure navigation

Concevoir un cadre
pour améliorer
l’aspect esthétique

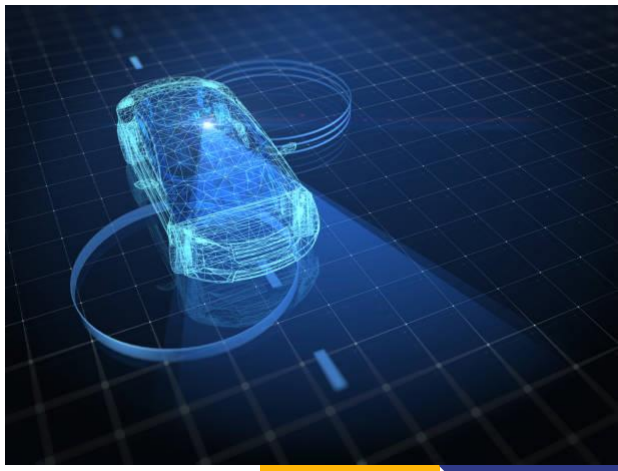
[picture p97: figure]

CREDITS: This presentation template was created by Slidesgo, (http://bit.ly/2Tynxth) including icons by Flaticon, (http://bit.ly/2TyoMsr) infographics & images by Freepik (http://bit.ly/2TtBDfr)

# Fin de la présentation

Merci pour votre attention

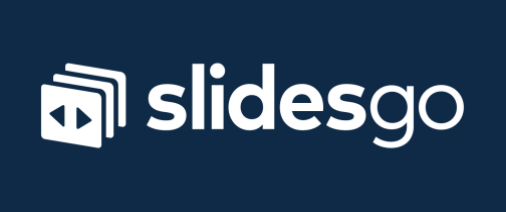
[picture p98: figure]
