ProjectAliB/ProjectAli.github.io/Ressources/Images&Pictures/download.jpeg

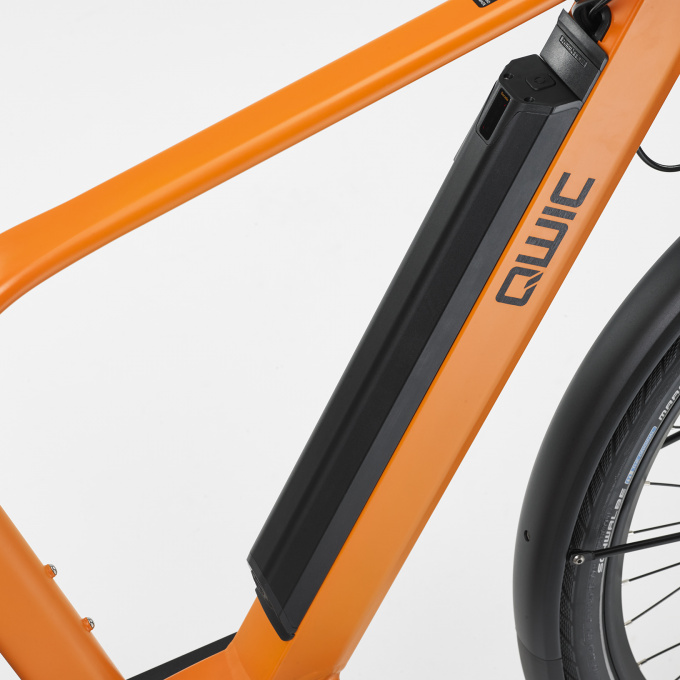
Ressources/Images&Pictures/download.jpeg
