ProjectAliB/ProjectAli.github.io/Ressources/Images&Pictures/IMG-20231208-WA0003.jpg

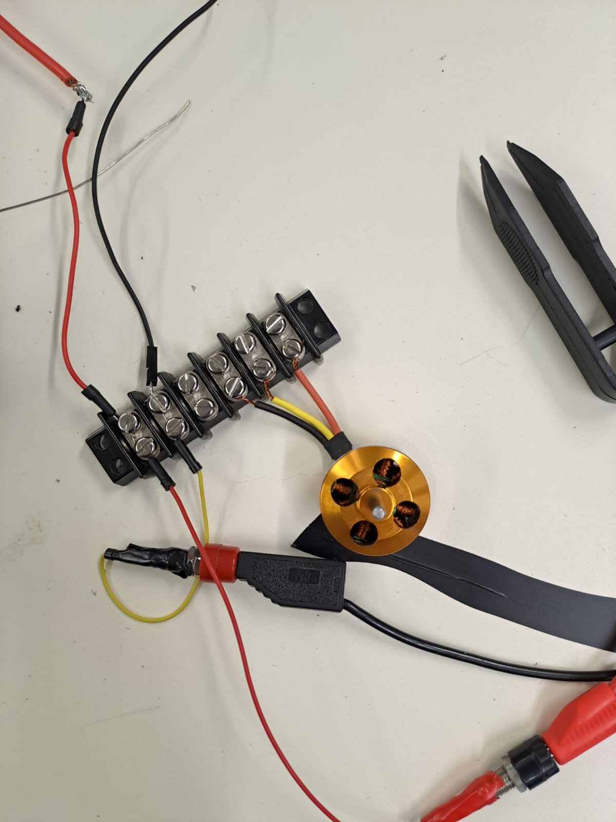
Ressources/Images&Pictures/IMG-20231208-WA0003.jpg
