ProjectAliB/ProjectAli.github.io/Ressources/Images&Pictures/IMG-20231208-WA0004.jpg

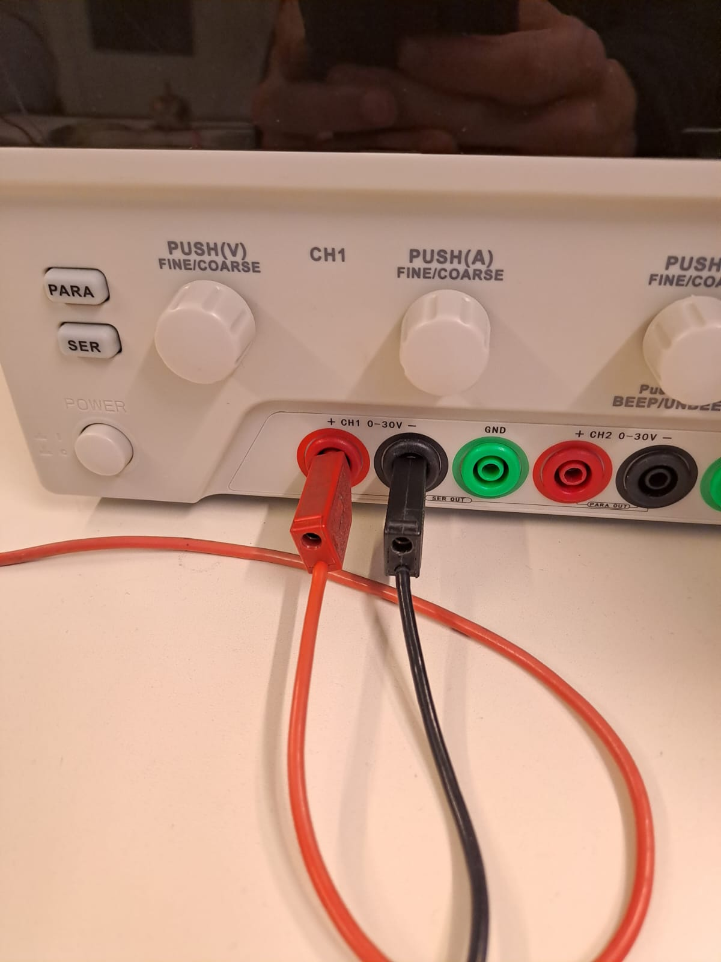
Ressources/Images&Pictures/IMG-20231208-WA0004.jpg
