ProjectAliB/ProjectAli.github.io/Ressources/Images&Pictures/IMG-20231208-WA0006.jpg

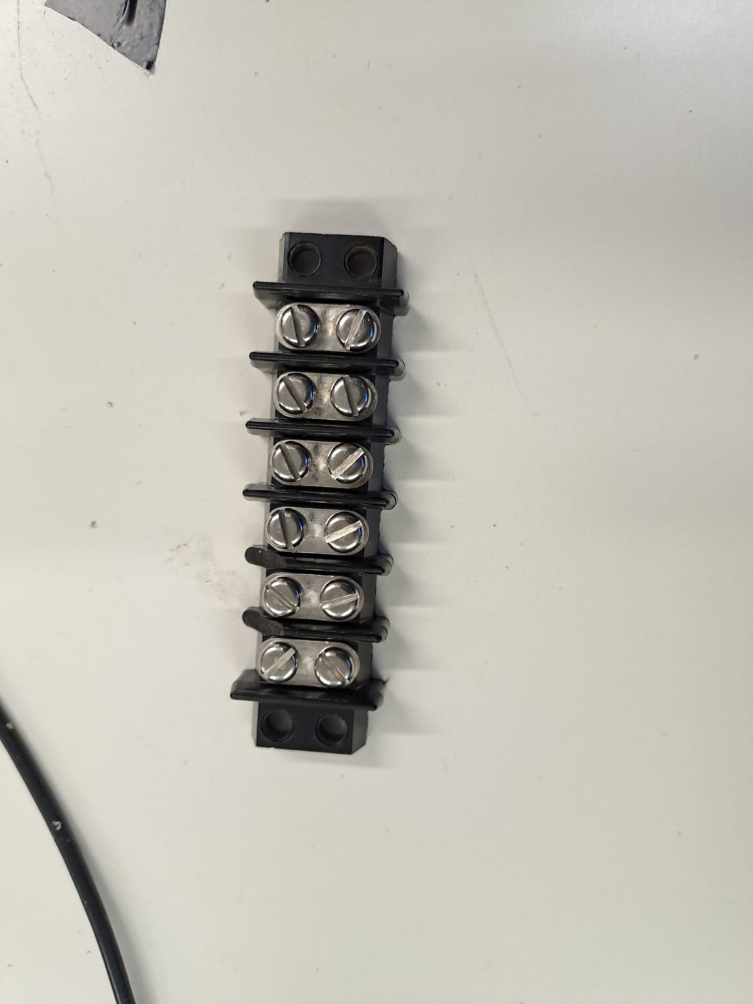
Ressources/Images&Pictures/IMG-20231208-WA0006.jpg
