ProjectAliB/ProjectAli.github.io/Ressources/Images&Pictures/rBVaEmJviaSAfZ97AAOCZBtXlH0336.webp

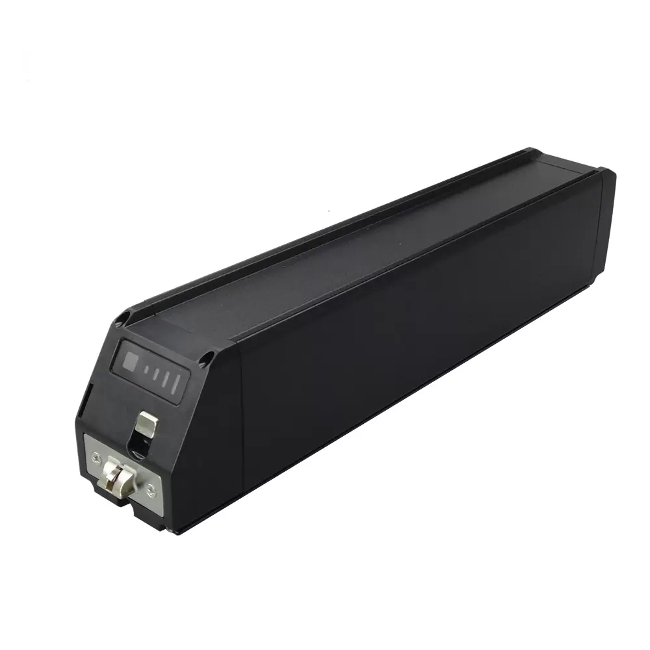
Ressources/Images&Pictures/rBVaEmJviaSAfZ97AAOCZBtXlH0336.webp
