ProjectAliB/ProjectAli.github.io/Ressources/Images&Pictures/regulateur-solaire-mppt-20a-12v24v48v-victron-smartsolar-10020.jpg

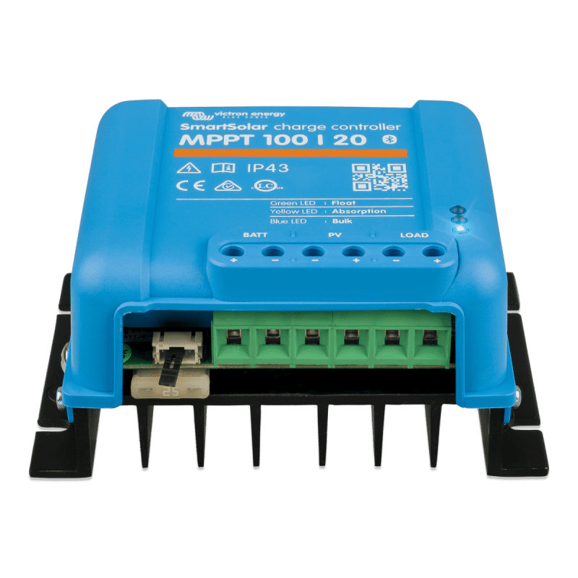
Ressources/Images&Pictures/regulateur-solaire-mppt-20a-12v24v48v-victron-smartsolar-10020.jpg
