ProjectAliB/ProjectAli.github.io/Ressources/Images&Pictures/Work session 04/IMG-20231212-WA0003.jpg

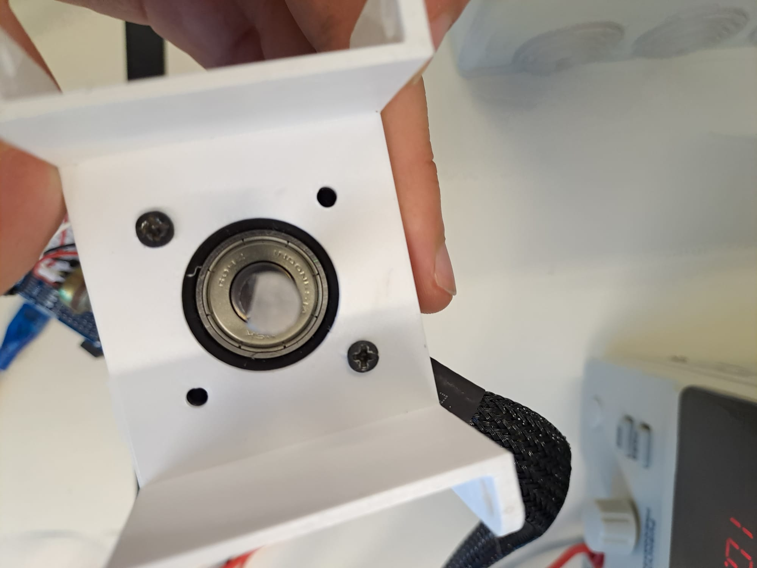
Ressources/Images&Pictures/Work session 04/IMG-20231212-WA0003.jpg
