ProjectAliB/ProjectAli.github.io/Ressources/Images&Pictures/Work session 07/IMG-20240123-WA0005.jpg

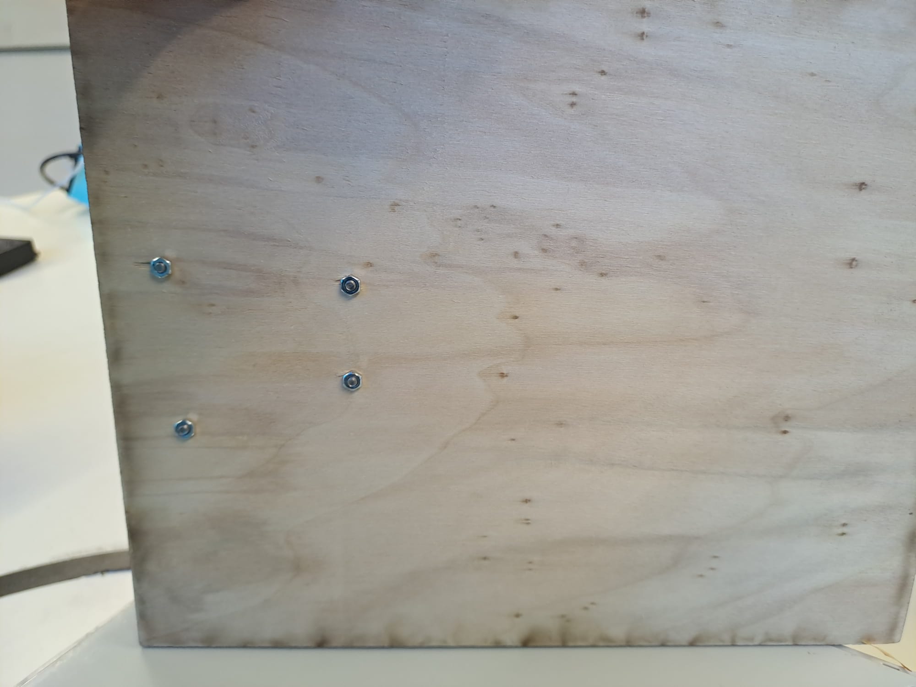
Ressources/Images&Pictures/Work session 07/IMG-20240123-WA0005.jpg
