ProjectAliB/ProjectAli.github.io/Ressources/Images&Pictures/Work session 08/20240207_153633.jpg

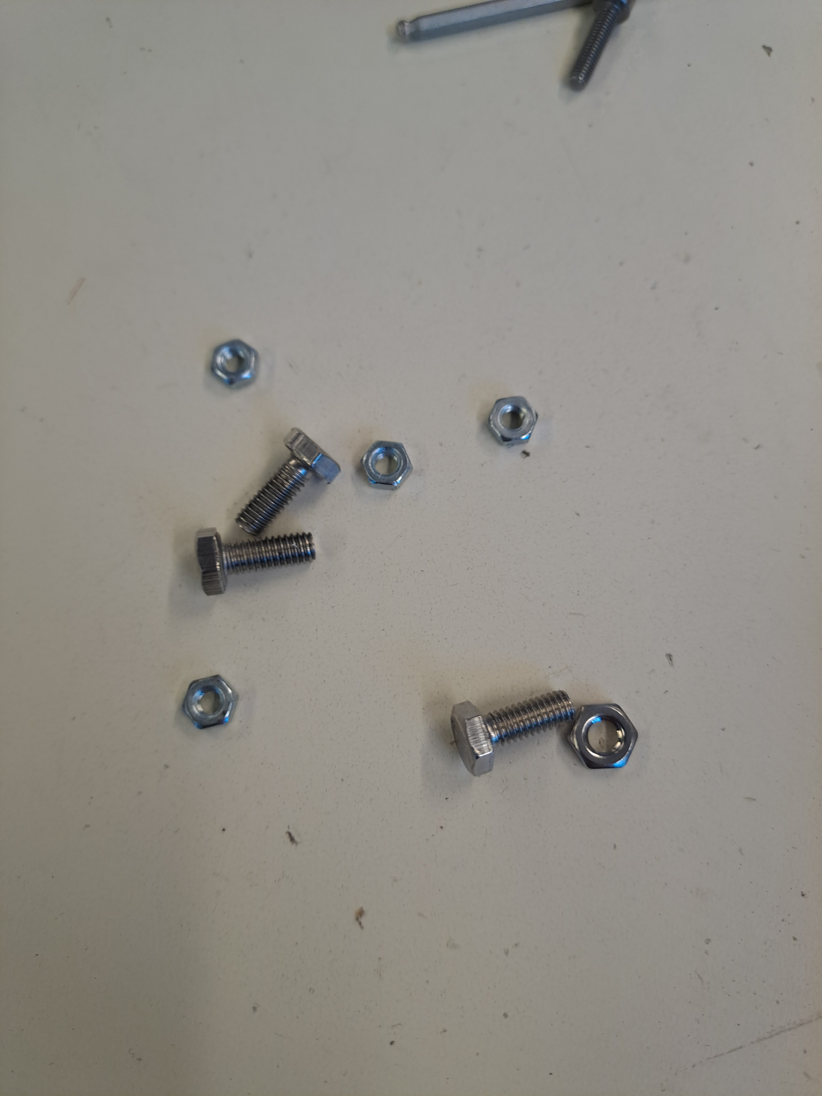
Ressources/Images&Pictures/Work session 08/20240207_153633.jpg
