ProjectAliB/ProjectAli.github.io/Ressources/Images&Pictures/Work session 08/20240207_174410.jpg

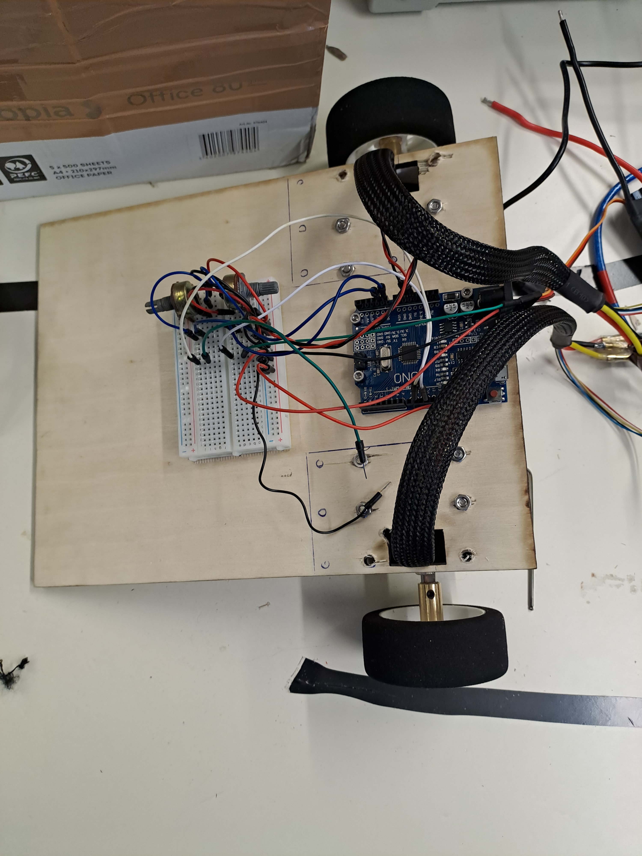
Ressources/Images&Pictures/Work session 08/20240207_174410.jpg
