ProjectAliB/ProjectAli.github.io/Ressources/Images&Pictures/Work session 10/20240221_170624.jpg

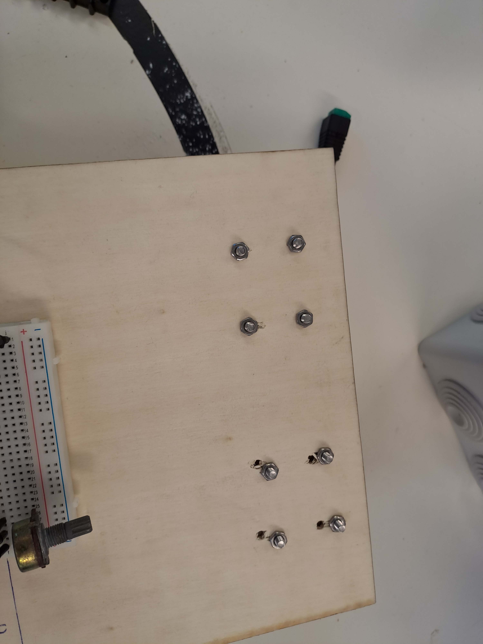
Ressources/Images&Pictures/Work session 10/20240221_170624.jpg
