ProjectAliB/ProjectAli.github.io/Ressources/Images&Pictures/Work session 13/WhatsApp Image 2024-03-19 at 15.00.32_0680e935.jpg

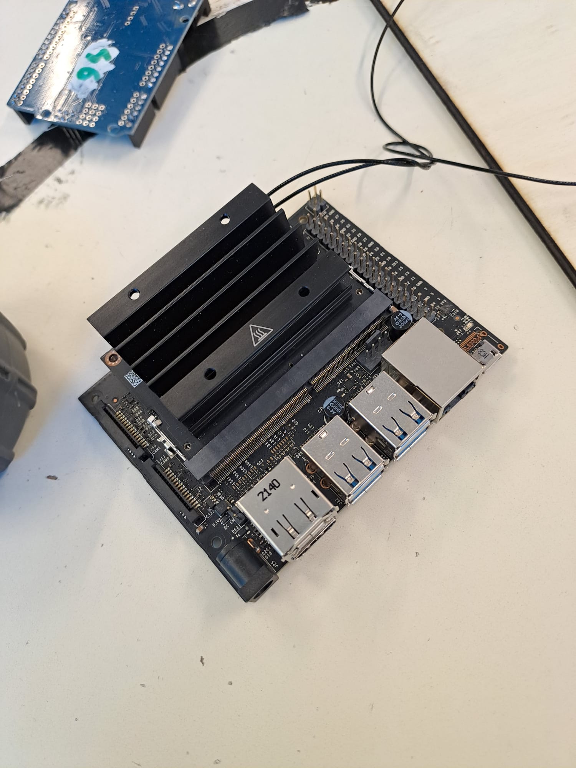
Ressources/Images&Pictures/Work session 13/WhatsApp Image 2024-03-19 at 15.00.32_0680e935.jpg
