ProjectAliB/ProjectAli.github.io/Ressources/Images&Pictures/Work session 14/WhatsApp Image 2024-03-29 at 14.07.36_9aeb67c5.jpg

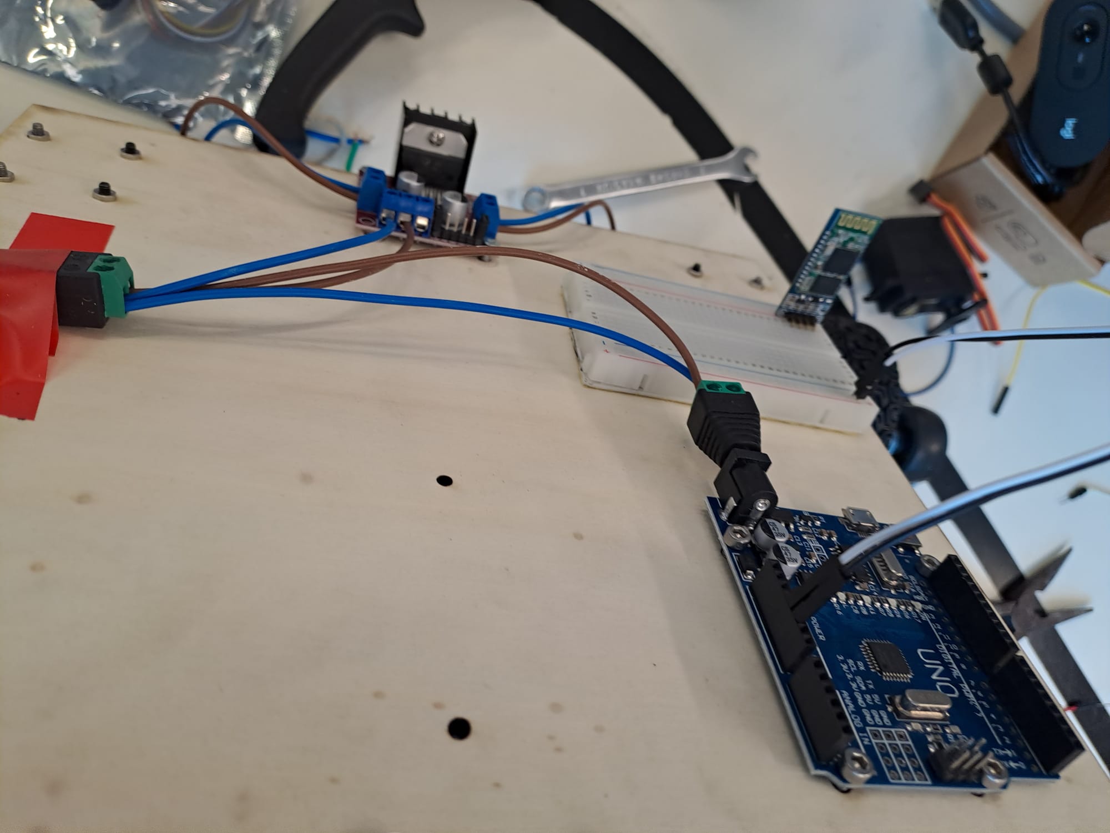
Ressources/Images&Pictures/Work session 14/WhatsApp Image 2024-03-29 at 14.07.36_9aeb67c5.jpg
