ProjectAliB/ProjectAli.github.io/Ressources/Images&Pictures/Week 17/Camera support v2.stl

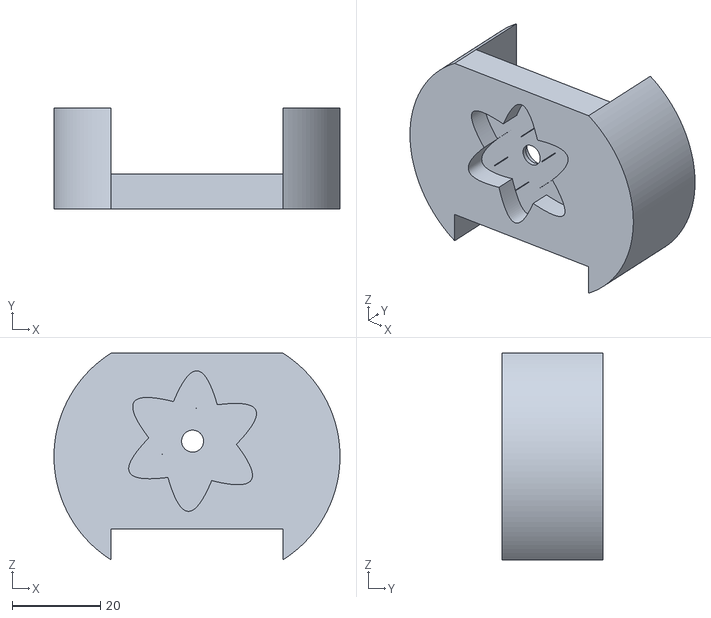
[picture p116: CAD file, 2024-04-17]
Ressources/Images&Pictures/Week 17/Camera support v2.stl
65.0 x 23.0 x 47.0
